takunii/mami-kbd/doc/electronic-products.md

## 商品購入リスト

- 3.7V 2000mAh Lipo ポリマーリチウム充電式バッテリー 103450 × 2Pcs
- Sk6812 MINI-E rgb (ws2812bと同様) sk6812 3228 smdピクセルLED ×　50Pcs
- MSS-22D18 X-2mm Black ×　20Pcs
- 6×6×5MM モメンタリ触覚タクトプッシュボタン × 10Pcs
- GRAEATZT NFR52840 ボード × 3Pcs
- 5ペアマイクロ JST PH2.0 2PIN オスメスプラグコネクターワイヤーケーブル 80mm ×　5 pair
- Kailhホットスワップ可能PCBソケット　× 70Pcs
- 9Cherry MX スイッチPCB実装スタップインスタビライザー 2u × 2Pcs
- 123 パッチスイッチダイオード × 100Pcs
