takunii/mami-kbd/version.md

## v3.5-screw
ケース高さを調節、ハウジングが横から見えないように修正

#v3.3
