takunii/mami-kbd/doc/pin-assignment-final.md

# mami42 最終ピンアサイン（裏面実装最適化）

> ⚠️ **2026-08-08 訂正**: 以下の本文は設計当初の計画であり、実際にPCB上で
> 配線されたピンとは異なることが判明しました。実機の配線(`cad/mami.kicad_pcb`の
> ネット情報で確認済み)は `boards/shields/mami42/mami42.overlay` の
> `row-gpios`/`col-gpios` が正です。実際の対応は以下の通りです:
>
> | 信号 | GPIO |
> |---|---|
> | row0 | P0.31 |
> | row1 | P1.11 |
> | row2 | P0.10 |
> | row3 | P0.09 |
> | row4 | P0.17 |
> | row5 | P0.11 |
> | row6 | P1.04 |
> | row7 | P1.06 |
> | col0 | P0.29 |
> | col1 | P0.02 |
> | col2 | P1.15 |
> | col3 | P0.20 |
> | col4 | P0.22 |
> | col5 | P0.24 |
>
> 以下の本文・表・コード例は当時の計画のまま残していますが、内容が古い点に注意してください。

## 🎯 最適化の考え方

### PCB裏面実装での配置
```
        PCB表面から見た配置
        
マトリクス左側          nice!nano(裏面)          マトリクス右側
  (左に配置)            (中央に配置)              (右に配置)
                    
                    回路図右側ピン
                    → 実装後は左側
                    → マトリクス左側に近い！
                    
                    回路図左側ピン  
                    → 実装後は右側
                    → マトリクス右側に近い！
```

### ✅ 最適化の原則
1. **ROW左側（4本）**: 回路図の**右側ピン**を使用 → 実装後は左側
2. **ROW右側（4本）**: 回路図の**左側ピン**を使用 → 実装後は右側
3. **COL（6本）**: 残りのピンを上側から順に使用
4. **横断配線を最小化**: ROWが左右に分かれているため横断不要

## 🔧 確定ピンアサイン

### 列（COL）ピン - 6本
```
col0: Pin 1  (P0.06/TX0)  - 回路図左側最上部 → 実装後は右側
col1: Pin 2  (P0.08/RX1)  - 回路図左側上部   → 実装後は右側
col2: Pin 5  (P0.17)      - 回路図左側上部   → 実装後は右側
col3: Pin 6  (P0.20)      - 回路図左側中央   → 実装後は右側
col4: Pin 7  (P0.22)      - 回路図左側中央   → 実装後は右側
col5: Pin 8  (P0.24)      - 回路図左側中央   → 実装後は右側
```
**配置**: COLが中央（実装後右側）に集約され、左右のマトリクスに配線しやすい

### 行（ROW）ピン - 左側4本
```
row0: Pin 13 (P0.09/NFC1) - 回路図右側最上部 → 実装後は左側 ⭐
row1: Pin 14 (P0.10/NFC2) - 回路図右側上部   → 実装後は左側 ⭐
row2: Pin 15 (P1.11)      - 回路図右側上部   → 実装後は左側 ⭐
row3: Pin 16 (P1.13)      - 回路図右側上部   → 実装後は左側 ⭐
```
**配置**: 実装後は左側に来るため、マトリクス左側への配線が短い！

### 行（ROW）ピン - 右側4本
```
row4: Pin 9  (P1.00)      - 回路図左側下部   → 実装後は右側 ⭐
row5: Pin 10 (P0.11)      - 回路図左側下部   → 実装後は右側 ⭐
row6: Pin 11 (P1.04)      - 回路図左側下部   → 実装後は右側 ⭐
row7: Pin 12 (P1.06)      - 回路図左側最下部 → 実装後は右側 ⭐
```
**配置**: 実装後は右側に来るため、マトリクス右側への配線が短い！

### 電源・その他
```
VCC:   Pin 21 (回路図右側下部)
GND:   Pin 3, 4, 23, 30
RST:   Pin 22 (回路図右側下部)
BATIN: Pin 24, 34 (回路図右側下部)
```

## 📐 配線イメージ（実装後・表面から見た場合）

```
マトリクス左側                nice!nano(裏面)               マトリクス右側
  (物理4行)                   (表面から見て)                  (物理4行)
                        
  row0 ─────→ Pin 13 (左側上部) ←─ 短い！
  row1 ─────→ Pin 14                         
  row2 ─────→ Pin 15                          Pin 9 (右側下部) ←──── row4
  row3 ─────→ Pin 16                          Pin 10             ←──── row5
                                              Pin 11             ←──── row6
                                              Pin 12 (右側下部)  ←──── row7
                                                     ↑
                                                   短い！
                                                   
  ← COL信号は中央(右側)から左右に分配 →
     Pin 1-8 (右側上～中央)
```

## ✅ この配線の利点

### 1. 横断配線がゼロ
- **ROW左（13-16）** → 実装後左側 → マトリクス左側に直接配線
- **ROW右（9-12）** → 実装後右側 → マトリクス右側に直接配線
- 横断する必要なし！

### 2. 配線が短い
- ROW信号が各マトリクス側に近い位置から出る
- 配線長が最短

### 3. 信号の分離
- ROW左は上部（Pin 13-16）
- ROW右は下部（Pin 9-12）
- 上下で分離されているため交差なし

### 4. COL信号の配線
- COL（Pin 1-8）は実装後右側中央に位置
- 左右のマトリクスに均等にアクセス可能

## 📊 ピン配置一覧表

| 機能 | Pin | GPIO | 回路図位置 | 実装後位置 | マトリクス |
|---|-----|---|---|---|---|
| col0 | 1 | P0.06 | 左上 | 右上 | 全体 |
| col1 | 2 | P0.08 | 左上 | 右上 | 全体 |
| col2 | 5 | P0.17 | 左上 | 右上 | 全体 |
| col3 | 6 | P0.20 | 左中 | 右中 | 全体 |
| col4 | 7 | P0.22 | 左中 | 右中 | 全体 |
| col5 | 8 | P0.24 | 左中 | 右中 | 全体 |
| row0 | 13 | P0.09 | 右上 | **左上** | **左側** ⭐ |
| row1 | 14 | P0.10 | 右上 | **左上** | **左側** ⭐ |
| row2 | 15 | P1.11 | 右上 | **左上** | **左側** ⭐ |
| row3 | 16 | P1.13 | 右上 | **左上** | **左側** ⭐ |
| row4 | 9 | P1.00 | 左下 | **右下** | **右側** ⭐ |
| row5 | 10 | P0.11 | 左下 | **右下** | **右側** ⭐ |
| row6 | 11 | P1.04 | 左下 | **右下** | **右側** ⭐ |
| row7 | 12 | P1.06 | 左下 | **右下** | **右側** ⭐ |

⭐ = 最適配置（横断配線なし）

## 🔌 回路図での接続方法

### nice!nanoシンボルの接続
```
nice!nano (回路図シンボル)

左側ピン:
1  → col0 (左右マトリクス全体へ)
2  → col1
5  → col2
6  → col3
7  → col4
8  → col5
9  → row4 (右側マトリクスへ) ⭐
10 → row5 (右側マトリクスへ) ⭐
11 → row6 (右側マトリクスへ) ⭐
12 → row7 (右側マトリクスへ) ⭐

右側ピン:
13 → row0 (左側マトリクスへ) ⭐
14 → row1 (左側マトリクスへ) ⭐
15 → row2 (左側マトリクスへ) ⭐
16 → row3 (左側マトリクスへ) ⭐
21 → VCC
22 → RST
23 → GND
24 → BATIN
```

## 💻 ZMK ファームウェア設定

```dts
/ {
    chosen {
        zmk,kscan = &kscan0;
    };

    kscan0: kscan {
        compatible = "zmk,kscan-gpio-matrix";
        label = "KSCAN";
        diode-direction = "col2row";
        
        row-gpios
            = <&gpio0 9 (GPIO_ACTIVE_HIGH | GPIO_PULL_DOWN)>   // P0.09 - row0 (左側)
            , <&gpio0 10 (GPIO_ACTIVE_HIGH | GPIO_PULL_DOWN)>  // P0.10 - row1 (左側)
            , <&gpio1 11 (GPIO_ACTIVE_HIGH | GPIO_PULL_DOWN)>  // P1.11 - row2 (左側)
            , <&gpio1 13 (GPIO_ACTIVE_HIGH | GPIO_PULL_DOWN)>  // P1.13 - row3 (左側)
            , <&gpio1 0 (GPIO_ACTIVE_HIGH | GPIO_PULL_DOWN)>   // P1.00 - row4 (右側)
            , <&gpio0 11 (GPIO_ACTIVE_HIGH | GPIO_PULL_DOWN)>  // P0.11 - row5 (右側)
            , <&gpio1 4 (GPIO_ACTIVE_HIGH | GPIO_PULL_DOWN)>   // P1.04 - row6 (右側)
            , <&gpio1 6 (GPIO_ACTIVE_HIGH | GPIO_PULL_DOWN)>   // P1.06 - row7 (右側)
            ;

        col-gpios
            = <&gpio0 6 GPIO_ACTIVE_HIGH>   // P0.06 - col0
            , <&gpio0 8 GPIO_ACTIVE_HIGH>   // P0.08 - col1
            , <&gpio0 17 GPIO_ACTIVE_HIGH>  // P0.17 - col2
            , <&gpio0 20 GPIO_ACTIVE_HIGH>  // P0.20 - col3
            , <&gpio0 22 GPIO_ACTIVE_HIGH>  // P0.22 - col4
            , <&gpio0 24 GPIO_ACTIVE_HIGH>  // P0.24 - col5
            ;
    };
};
```

## 📝 マトリクス配線対応表

### 左側マトリクス（物理1～4行目）
| 物理行 | 回路図 | ピン | GPIO | 実装後位置 |
|---|---|-----|---|---|
| 1行目 | row0 | 13 | P0.09 | 左側上部 ⭐ |
| 2行目 | row1 | 14 | P0.10 | 左側上部 ⭐ |
| 3行目 | row2 | 15 | P1.11 | 左側上部 ⭐ |
| 4行目 | row3 | 16 | P1.13 | 左側上部 ⭐ |

### 右側マトリクス（物理1～4行目）
| 物理行 | 回路図 | ピン | GPIO | 実装後位置 |
|---|---|-----|---|---|
| 1行目 | row4 | 9 | P1.00 | 右側下部 ⭐ |
| 2行目 | row5 | 10 | P0.11 | 右側下部 ⭐ |
| 3行目 | row6 | 11 | P1.04 | 右側下部 ⭐ |
| 4行目 | row7 | 12 | P1.06 | 右側下部 ⭐ |

## ✅ まとめ

### この最終ピンアサインを使用する理由：
1. **横断配線ゼロ**: ROWが左右に分かれているため
2. **配線が最短**: 各ROWが対応するマトリクス側に直接接続
3. **信号の分離**: 上下で分離され交差なし
4. **PCB設計が簡単**: ルーティングが直感的

### このピンアサインで回路図を作成してください！
