takunii/mami-kbd/doc/case.md

## アルミニウムケースの寸法決め

### パーツ寸法

### レイヤー毎の寸法
PCB幅　253.0/87.5
ケース内側  　
ケース外側

|外側ケース|ガスケット|基盤|
|:--:|:--:|:--:|
||b|c|
||||
