takunii/mami-kbd/doc/why-capacitors-required.md

# なぜコンデンサ・抵抗が必要か - LED有無に関わらず必須

## ❌ よくある誤解

> 「LEDなしにするから、コンデンサは不要だよね？」

**これは間違いです！**

## ✅ 正しい理解

### LED有無とコンデンサの関係

```
LED有り の場合:
├── 基本コンデンサ（必須）
│   ├── デカップリング 0.1μF × 4-5個  ← マイコン用（必須）
│   └── バイパス 10μF × 1-2個         ← マイコン用（必須）
└── LED用コンデンサ（追加）
    └── バイパス 10μF × 2個           ← LED電源安定化用

LED無し の場合:
└── 基本コンデンサ（必須）
    ├── デカップリング 0.1μF × 4-5個  ← マイコン用（必須）
    └── バイパス 10μF × 1-2個         ← マイコン用（必須）
```

**LEDをなしにしても、基本コンデンサは必須です！**

---

## 🔌 なぜコンデンサが必須なのか

### 1. デカップリングキャパシタ（0.1μF × 4-5個）

#### 役割: マイコンの電源ノイズ除去

```
VCC (3.3V) ─┬───────── nice!nano/GRAEATZT NFR52840
            │
            ├─ [C1: 0.1μF] ── GND
            ├─ [C2: 0.1μF] ── GND
            ├─ [C3: 0.1μF] ── GND
            └─ [C4: 0.1μF] ── GND

配置: マイコンの近く（5mm以内）
```

#### なぜ必要か

**マイコンの内部動作:**
- CPUクロック: 64MHz（nRF52840）
- GPIO切り替え: 数MHz～数十MHz
- 無線通信: 2.4GHz
- これらが**瞬間的に電流を消費**

**コンデンサがないと:**
```
❌ 電源電圧が不安定
   → VCC: 3.3V → 3.1V → 3.4V → 2.9V...（変動）
   
❌ 高周波ノイズが発生
   → デジタル信号が乱れる
   
❌ マイコンが誤動作
   → 突然リセット
   → キー入力が認識されない
   → Bluetooth接続が不安定
   → USB通信エラー
```

**コンデンサがあると:**
```
✅ 瞬間的な電流変動を吸収
✅ 電源電圧を3.3Vに安定維持
✅ 高周波ノイズを除去
✅ マイコンが安定動作
```

---

### 2. バイパスキャパシタ（10μF × 1-2個）

#### 役割: 電源電圧の急激な変動を抑制

```
VCC (3.3V) ─┬───────── nice!nano/GRAEATZT NFR52840
            │
            └─ [C_BYPASS: 10μF] ── GND

配置: マイコンの直近
```

#### なぜ必要か

**マイコンの動作モード変化:**
```
スリープモード: 数μA
  ↓ 突然の変化
通信モード: 数十mA～100mA以上
```

この**瞬間的な電流変化**が問題になります。

**バイパスキャパシタがないと:**
```
❌ スリープ→通信時に電圧降下
   VCC: 3.3V → 2.8V（瞬間的）
   
❌ マイコンが電圧不足でリセット
   → 突然再起動
   → Bluetooth切断
   → キー入力が消える
```

**バイパスキャパシタがあると:**
```
✅ コンデンサに貯めた電荷で瞬間的な電流をカバー
✅ 電源電圧の急激な降下を防ぐ
✅ マイコンが安定動作
```

---

### 3. プルアップ抵抗（10kΩ × 1個）

#### 役割: リセットピンを安定させる

```
VCC (3.3V)
  │
  └─ [R1: 10kΩ] ──┬── nice!nano Pin 22 (RST)
                   │
               [SW_RST]
                   │
                  GND
```

#### なぜ必要か

**RSTピンの特性:**
- Low (0V): リセット実行
- High (3.3V): 通常動作
- **未接続（フローティング）: 不定（危険！）**

**プルアップ抵抗がないと:**
```
❌ RSTピンがフローティング状態
   → ノイズで勝手にLowになる
   → 突然リセット
   → 常にリセット状態で起動しない
```

**プルアップ抵抗があると:**
```
✅ RSTピンを常にHighに保つ
✅ ボタンを押したときだけLowになる
✅ 正常にリセット機能が動作
```

---

## 📊 LED有無による部品の違い

### LED無しの場合（初号機）

#### 必須部品
| 部品 | 数量 | 用途 | LED有無 |
|---|---|---|---|
| 0.1μF コンデンサ (0603) | 4-5個 | デカップリング | **常に必須** ⭐ |
| 10μF コンデンサ (0805) | 1-2個 | バイパス | **常に必須** ⭐ |
| 10kΩ 抵抗 (0603) | 1個 | リセット回路 | **常に必須** ⭐ |

#### 不要な部品
| 部品 | 数量 | 用途 | LED有無 |
|---|---|---|---|
| 470Ω 抵抗 (0603) | 1個 | LED信号保護 | LED無しなら不要 |
| 10μF コンデンサ (0805) | 2個追加 | LED電源安定化 | LED無しなら不要 |
| SK6812 MINI-E LED | 42-50個 | バックライト | LED無しなら不要 |

---

## 🎯 LED無し初号機の最終購入リスト

### ✅ 既に購入予定（確定）
- [x] GRAEATZT NFR52840 × 3個
- [x] 3.7V 2000mAh バッテリー × 2個
- [x] JST PH2.0 コネクター × 5ペア
- [x] MSS-22D18 パワースイッチ × 20個
- [x] Kailhホットスワップソケット × 70個
- [x] ダイオード 1N4148W × 100個
- [x] タクトスイッチ 6×6×5mm × 10個
- [x] 2u スタビライザー × 2個

### ❌ 絶対に追加購入が必要
- [ ] **0.1μF セラミックコンデンサ (0603) × 5個以上**
- [ ] **10μF セラミックコンデンサ (0805) × 2個以上**
- [ ] **10kΩ 抵抗 (0603) × 1個以上**

### 不要（LEDなしのため）
- ~~SK6812 MINI-E LED × 50個~~ → 保留または返品
- ~~470Ω 抵抗~~ → 不要
- ~~LED用追加10μFコンデンサ~~ → 不要

---

## 💰 推奨購入: アソートセット

### なぜアソートセットが良いか

**個別購入の問題:**
```
0.1μF × 5個: 送料込み $5
10μF × 2個: 送料込み $5
10kΩ × 1個: 送料込み $5
─────────────────────
合計: $15
```

**アソートセット:**
```
SMD 0603/0805 コンデンサ・抵抗セット
- 0.1μF × 20-50個
- 10μF × 20-50個
- 10kΩ × 20-50個
- その他各値も含む
価格: $8-12（送料込み）
```

**メリット:**
- ✅ 安い（$15 → $10程度）
- ✅ 予備がたくさん（失敗しても安心）
- ✅ 今後のプロジェクトに使える
- ✅ 2号機（LED有り）を作るときにも使える

---

## 🔍 実際の失敗例

### ケース1: コンデンサなしで作った人
```
状況: デカップリングキャパシタを省略
結果: 
- キーを押すとマイコンがリセット
- Bluetooth接続が数秒で切れる
- USB接続が不安定
解決: コンデンサを追加して正常動作
```

### ケース2: プルアップ抵抗なしで作った人
```
状況: リセット回路の抵抗を省略
結果:
- 電源を入れても起動しない
- 常にリセット状態
- ファームウェアを書き込めない
解決: 10kΩ抵抗を追加して正常動作
```

---

## ✅ まとめ

### LED有無に関係なく必須
1. **0.1μF コンデンサ × 4-5個** - マイコンのノイズ除去
2. **10μF コンデンサ × 1-2個** - 電源安定化
3. **10kΩ 抵抗 × 1個** - リセット回路

### これらがないと
- ❌ マイコンが誤動作・突然リセット
- ❌ Bluetooth/USB通信が不安定
- ❌ キー入力が認識されない
- ❌ リセットボタンが機能しない
- ❌ 最悪の場合、全く動作しない

### LEDをなしにして減る部品
- LED本体 × 42-50個
- LED用470Ω抵抗 × 1個
- LED用追加10μFコンデンサ × 2個

**基本のコンデンサ・抵抗は絶対に必要です！**

---

## 🛒 今すぐ購入すべきもの

```
AliExpressで検索:
"SMD 0603 0805 capacitor resistor kit"

推奨商品:
- SMD 0603/0805 コンデンサ・抵抗アソートセット
- 価格: $8-15
- 各値10-50個入り
```

**これを1セット買えば、すべて解決します！**

LED有り2号機を作るときも使えるので、今買っておくのがベストです。
