takunii/mami-kbd/image.png

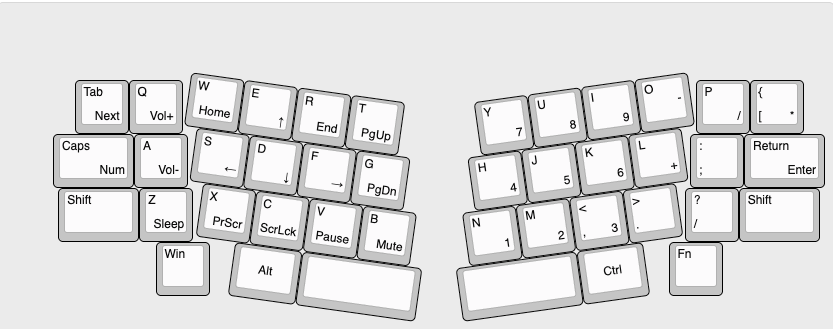
image.png
