takunii/mami-kbd/doc/shopping-list-review.md

# mami42 電子部品購入リスト - レビューと追加必要部品

## 📋 現在の購入予定リスト（確認）

| 部品名 | 数量 | 用途 | ステータス |
|---|---|---|---|
| 3.7V 2000mAh Lipo バッテリー 103450 | 2個 | 無線電源 | ✅ OK（容量大きめで良い） |
| SK6812 MINI-E RGB LED (3228 SMD) | 50個 | キーバックライト | ⚠️ 確認必要 |
| MSS-22D18 X-2mm Black | 20個 | パワースイッチ？ | ⚠️ 用途確認 |
| 6×6×5MM タクトスイッチ | 10個 | リセットボタン | ✅ OK |
| GRAEATZT NFR52840 ボード | 3個 | マイコン | ⚠️ nice!nano推奨 |
| JST PH2.0 2PIN コネクター 80mm | 5ペア | バッテリー接続 | ✅ OK |
| Kailhホットスワップソケット | 70個 | キースイッチ | ✅ OK（余裕あり） |
| 2u Cherry MXスタビライザー | 2個 | 2uキー用 | ⚠️ 数量確認 |
| パッチダイオード（1N4148W？） | 100個 | キーマトリクス | ✅ OK |

---

## ⚠️ 重要な確認事項

### 1. マイコンボード - ✅ 確認済み
**現在:** GRAEATZT NFR52840 ボード × 3個

**ステータス: ✅ OK**
- nice!nano v2互換確認済み
- Pro Micro互換ピン配置
- 1個で十分だが、予備に3個購入は賢明
- 購入URL確認済み（AliExpress）

**このまま使用できます！**

---

### 2. SK6812 MINI-E LED - 重要な設計変更
**LED追加による影響:**

#### ピンアサインの変更が必要
- **データピン追加**: SK6812はシリアル制御のため、1本のデータピンが必要
- **現在の設計**: GPIO 14本使用（COL 6本 + ROW 8本）
- **LED用ピン**: Pin 17 (P1.15) などを使用可能

#### LED接続方法
```
nice!nano Pin 17 (P1.15)
    │
    └─→ [First LED] → [Second LED] → ... → [42nd LED]
         ↓           ↓                    ↓
        SW1         SW2                  SW42
        
各LEDの電源:
VCC ─┬─ LED1 VDD
     ├─ LED2 VDD
     └─ LED42 VDD
     
GND ─┬─ LED1 GND
     ├─ LED2 GND
     └─ LED42 GND
```

#### 追加で必要な設計変更
1. **回路図の修正**: LED回路の追加
2. **PCB設計の修正**: 各キースイッチ下にLED配置スペース
3. **電力計算**: 42個のLED消費電力を考慮
   - SK6812 MINI-E: 最大15mA/色 × 3色 = 45mA/個
   - 全点灯: 42個 × 45mA = 1.89A（最大）
   - 実用: 約500mA（明るさ調整で使用）

#### バッテリー容量の見直し
- **現在**: 2000mAh Li-Po
- **LED付きの場合**:
  - LED消費: 平均300-500mA
  - nice!nano: 約5-10mA
  - 合計: 約310-510mA
  - **稼働時間**: 2000mAh ÷ 500mA = 約4時間
  - ✅ 容量は十分

---

### 3. スタビライザー - ✅ 確認済み
**現在:** 2u スタビライザー × 2個

**ステータス: ✅ OK**
- スペースキー: 2u × 2個
- 合計2個の2uスタビライザーで十分
- 追加購入不要

**このまま使用できます！**

---

### 4. MSS-22D18 スイッチ - ✅ 確認済み
**購入予定:** MSS-22D18 X-2mm Black × 20個

**ステータス: ✅ OK**
- 用途: パワースイッチ（バッテリーON/OFF）
- 立った状態で実装可能（MSK-12C02は寝た状態なので不採用）
- 実際には1個のみ使用、残り19個は予備
- AliExpressの最小購入単位が20個のため

**このまま使用できます！**

---

## ❌ 足りない部品リスト（重要！）

### ⚠️ 絶対に必要な部品（電源回路）

**これらがないとキーボードが動作しません！**

| 部品名 | 型番推奨 | 数量 | 用途 | なぜ必要か |
|---|---|---|---|---|
| セラミックコンデンサ 0.1μF | 0603 | 5個 | デカップリング | マイコンの電源ノイズ除去。**ないとマイコンが誤動作・リセットする** |
| セラミックコンデンサ 10μF | 0805 | 2個 | バイパス | 電源電圧の急激な変動を抑制。**ないとマイコンが安定動作しない** |
| 抵抗 10kΩ | 0603 | 1-2個 | リセット回路 | リセットピンをVCCにプルアップ。**ないとリセットボタンが機能しない** |

### 推奨部品（LED用）
| 部品名 | 型番推奨 | 数量 | 用途 | 理由 |
|---|---|---|---|---|
| 抵抗 470Ω | 0603 | 1個 | LED信号保護 | データピン保護（短絡・サージ対策） |
| コンデンサ 10μF | 0805 | 2個追加 | LED電源安定化 | 42個LED点灯時の電流変動を抑制 |
| 保護ダイオード | 1N4148W (SOD-123) | 1個 | バッテリー保護 | 逆接続時の保護（推奨） |

### 💡 なぜコンデンサ・抵抗が必要か

#### デカップリングキャパシタ（0.1μF × 5個）
```
VCC ─┬─ nice!nano
     │
     ├─ [C1: 0.1μF] ─┬─ GND （マイコン左上近く）
     ├─ [C2: 0.1μF] ─┤
     ├─ [C3: 0.1μF] ─┤
     ├─ [C4: 0.1μF] ─┤
     └─ [C5: 0.1μF] ─┘

役割: 高周波ノイズを除去
ないと: マイコンが誤動作、突然リセット、通信エラー
```

#### バイパスキャパシタ（10μF × 2-4個）
```
VCC ─┬─ nice!nano
     │
     ├─ [C_BYPASS: 10μF] ── GND
     │
     └─ [LED用: 10μF × 2] ── GND

役割: 瞬間的な電流変動を吸収
ないと: 電圧降下でマイコンリセット、LED点滅時の不安定動作
```

#### プルアップ抵抗（10kΩ × 1個）
```
VCC ─── [R1: 10kΩ] ──┬── nice!nano Pin 22 (RST)
                      │
                  [SW_RST]
                      │
                     GND

役割: リセットピンをHighに保つ
ないと: リセットボタン押しても動作しない、または常にリセット状態
```

---

## ✅ 修正後の推奨購入リスト

### マイコン・通信
- [x] **GRAEATZT NFR52840** × 3個（nice!nano v2互換確認済み）

### 電源関連
- [x] 3.7V 2000mAh Li-Po バッテリー × 2個
- [x] JST PH2.0 コネクター × 5ペア
- [x] **パワースイッチ MSS-22D18** × 20個（1個使用、19個予備）

### スイッチ・ダイオード
- [x] Kailhホットスワップソケット × 70個
- [x] ダイオード 1N4148W × 100個
- [x] タクトスイッチ 6×6×5mm × 10個（リセット用）
- [x] 2u スタビライザー × 2個

### LED関連
- [x] SK6812 MINI-E RGB LED × 50個

### ⭐ 追加必要部品
- [ ] **セラミックコンデンサ 0.1μF (0603)** × 10個セット
- [ ] **セラミックコンデンサ 10μF (0805)** × 10個セット
- [ ] **抵抗 10kΩ (0603)** × 10個セット
- [ ] **抵抗 470Ω (0603)** × 10個セット（LED用）

---

## 💰 AliExpress/LCSC購入推奨セット

### ⭐ 推奨: コンデンサ・抵抗アソートメント

**これを1セット購入すれば必要な部品が全部揃います！**

```
🛒 SMD 0603/0805 コンデンサ・抵抗アソートセット
- 各値10-50個入り
- コンデンサ: 0.1μF, 1μF, 10μF など
- 抵抗: 470Ω, 1kΩ, 10kΩ など
価格: 約$5-15
```

**AliExpress検索ワード:**
- "SMD capacitor resistor kit 0603 0805"
- "SMD component assortment kit"
- "0603 0805 capacitor resistor sample book"

**具体的な商品例:**
1. **0603/0805 コンデンサキット** (約$8-12)
   - 0.1μF, 1μF, 10μF, 100μF など各値10-20個
   
2. **0603 抵抗キット** (約$5-8)
   - 470Ω, 1kΩ, 10kΩ, 100kΩ など各値20-50個

3. **オールインワン SMDキット** (約$15-20)
   - コンデンサ・抵抗・ダイオードがセットで入っている
   - 今後のプロジェクトにも使える

**これを購入すれば:**
✅ 必要な部品が全部揃う
✅ 個別購入より安い
✅ 余った部品は今後使える
✅ 失敗・紛失時の予備もある

---

## 🔍 購入前の確認事項

### 1. マイコンの確認
```
GRAEATZT NFR52840ボードのピン配置を確認:
- nice!nano v2互換か？
- Pro Micro互換か？
- ピン配置図を確認してください
```

### 2. LEDの仕様確認
```
SK6812 MINI-E (3228 SMD):
✅ サイズ: 3.2mm × 2.8mm
✅ 電圧: 5V動作が一般的だが、3.3V動作可能か確認
⚠️ 3.3V動作の場合、明るさが低下する可能性
```

### 3. スタビライザーの確認
```
レイアウトを確認して必要な種類を特定:
- 2u: 何個必要か
- 2.25u: 必要か
- 2.75u: 必要か
```

---

## 📦 最終購入チェックリスト

### 確定済み
- [x] バッテリー 2000mAh × 2
- [x] SK6812 MINI-E LED × 50
- [x] タクトスイッチ × 10
- [x] JST PH2.0 コネクター × 5ペア
- [x] Kailhホットスワップソケット × 70
- [x] ダイオード × 100

### ✅ 確認済み
- [x] マイコン: GRAEATZT NFR52840（nice!nano v2互換）
- [x] パワースイッチ: MSS-22D18（立った状態で実装可能）
- [x] スタビライザー: 2u × 2個（スペースキー2u × 2）

### 追加必須
- [ ] **コンデンサ 0.1μF (0603) × 5個以上**
- [ ] **コンデンサ 10μF (0805) × 2個以上**
- [ ] **抵抗 10kΩ (0603) × 2個以上**
- [ ] **抵抗 470Ω (0603) × 1個以上**（LED用）

### 推奨アソート
- [ ] **SMD 0603/0805 コンデンサ・抵抗セット** × 1セット

---

## 🎯 まとめ

### ❌ 絶対に追加購入が必要（動作に必須）
1. **0.1μF コンデンサ (0603) × 5個** - デカップリング用
2. **10μF コンデンサ (0805) × 2-4個** - バイパス・LED電源用
3. **10kΩ 抵抗 (0603) × 1-2個** - リセット回路用
4. **470Ω 抵抗 (0603) × 1個** - LED信号保護用

**💡 推奨:** SMD 0603/0805アソートセット × 1個（$5-15）
→ 上記すべてが含まれており、今後も使える

### ✅ 購入リスト確認済み
- [x] マイコン: GRAEATZT NFR52840 × 3個（nice!nano v2互換）
- [x] パワースイッチ: MSS-22D18 × 20個（立った状態実装）
- [x] スタビライザー: 2u × 2個（十分）
- [x] バッテリー: 2000mAh × 2個
- [x] LED: SK6812 MINI-E × 50個
- [x] その他すべて確認済み

### 📝 LED追加による設計変更が必要
1. 回路図にLED回路追加（データピン: Pin 17推奨）
2. PCBに各キー下のLED配置スペース確保
3. LED用データピン配線追加
4. ZMKファームウェアでRGB設定追加

### 🚨 重要
**コンデンサと抵抗がないと、キーボードは正常動作しません！**
必ずSMD 0603/0805のアソートセットを購入してください。
