takunii/mami-kbd/cad/.step

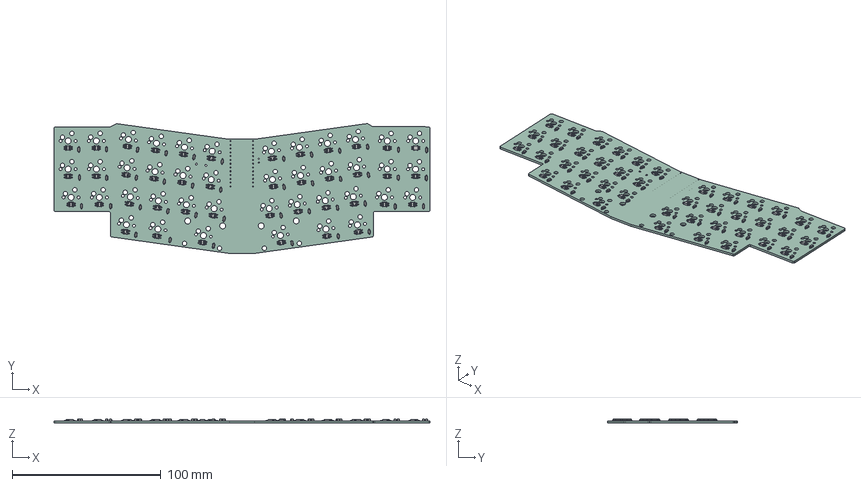
[picture p2: CAD file, 2026-06-06]
cad/.step
253.1 x 87.4 x 2.85 mm
D_SOD-123 x 42
Pin1 x 42
Pin2 x 42
Pin3 x 42
Pin4 x 42
mami_PCB
