takunii/mami-kbd/dxf/pcb_bottom_case.dxf

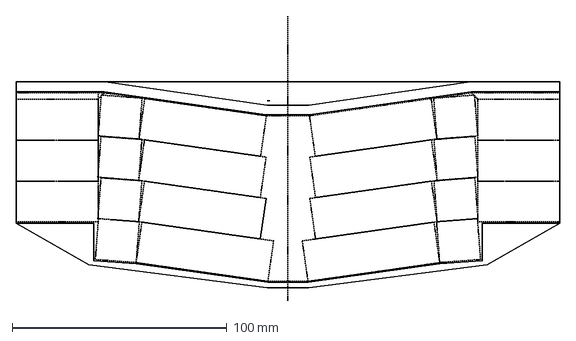
[picture p3: CAD file, 2026-08-04]
dxf/pcb_bottom_case.dxf
252.8 x 132.2 mm
