takunii/mami-kbd/step/carot48_top.step

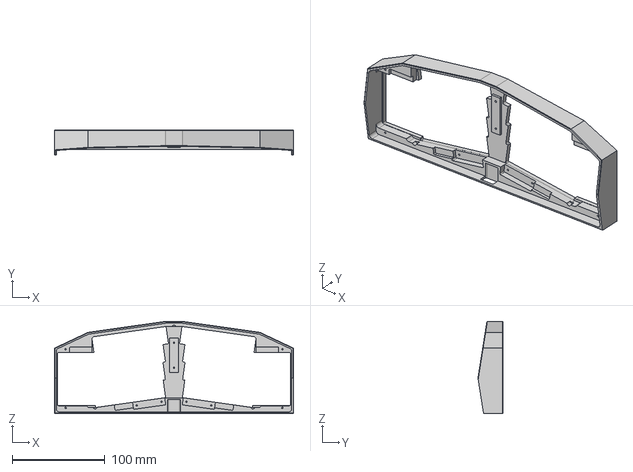
[picture p4: CAD file, 2026-08-04]
step/carot48_top.step
258.0 x 27.1 x 99.6 mm
