takunii/mami-kbd/step/v3.3/carot42_top_case.step

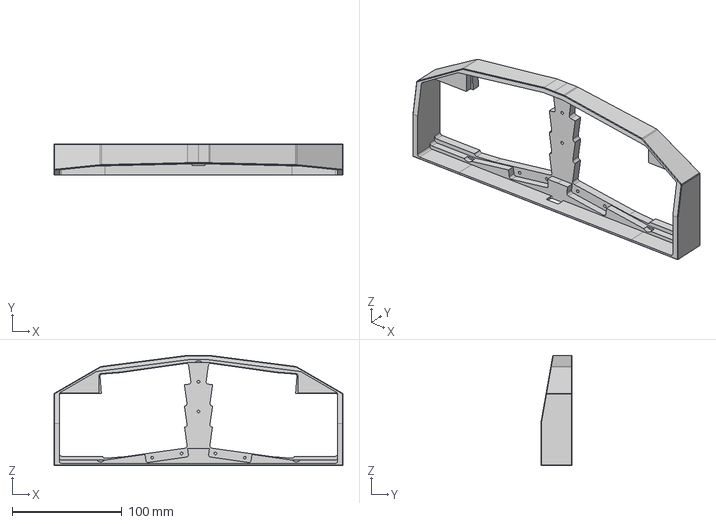
[picture p5: CAD file, 2026-08-04]
step/v3.3/carot42_top_case.step
262.8 x 28.6 x 100.3 mm
