takunii/mami-kbd/symbols/Keebio-Parts.pretty-master/3dmodels/SK6812MINI-E v1.step

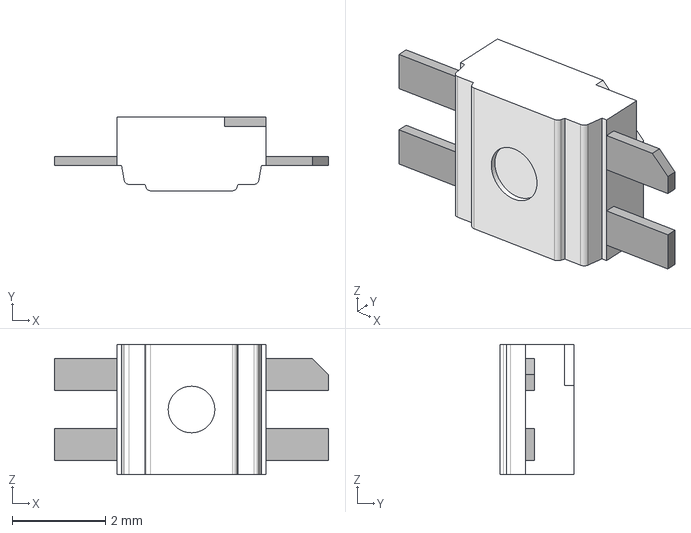
[picture p6: CAD file, 2026-06-15]
symbols/Keebio-Parts.pretty-master/3dmodels/SK6812MINI-E v1.step
5.88 x 1.58 x 2.80 mm
