takunii/mami-kbd/cad/mami-Edge_Cuts.dxf

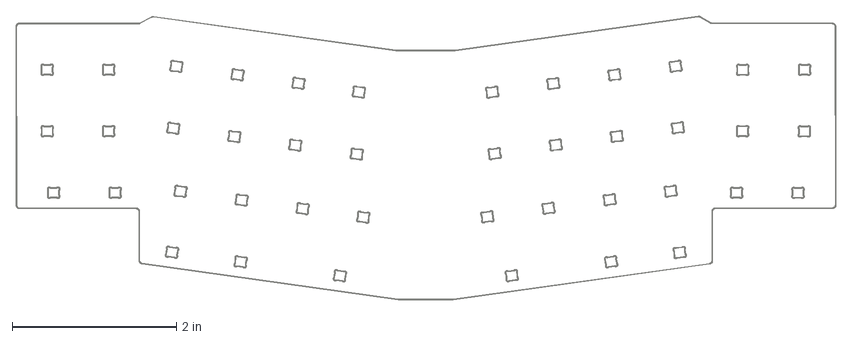
[picture p7: CAD file, 2026-06-06]
cad/mami-Edge_Cuts.dxf
9.97 x 3.44 in
