takunii/mami-kbd/dxf/pcb_edge.dxf

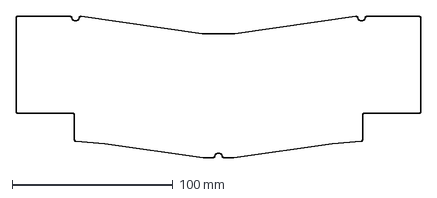
[picture p8: CAD file, 2026-08-04]
dxf/pcb_edge.dxf
251.8 x 87.8 mm
