takunii/mami-kbd/step/carot42_top_20260703.step

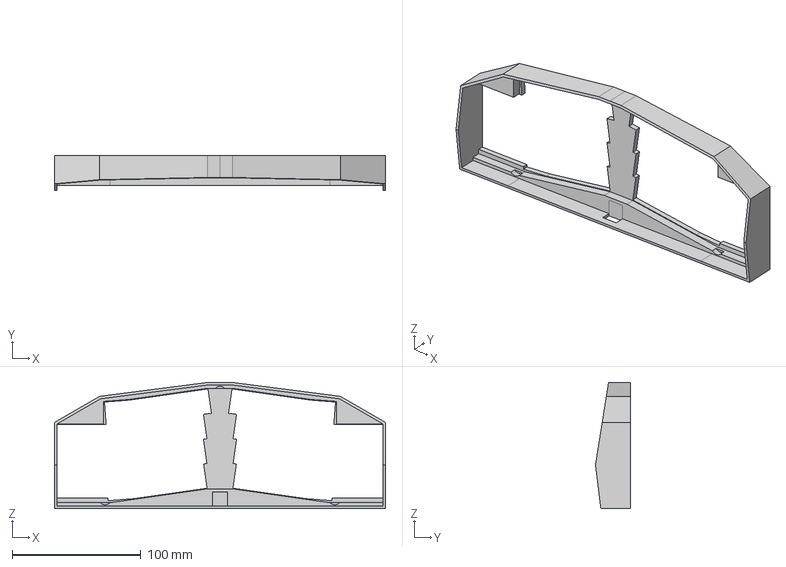
[picture p9: CAD file, 2026-08-04]
step/carot42_top_20260703.step
256.8 x 27.2 x 97.8 mm
