takunii/mami-kbd/step/v3.3/carot42_bottom_case.step

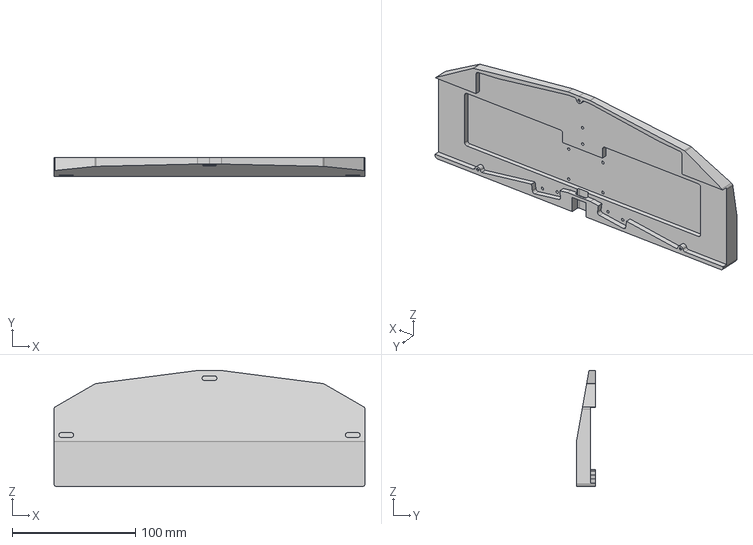
[picture p10: CAD file, 2026-08-04]
step/v3.3/carot42_bottom_case.step
252.8 x 15.6 x 94.3 mm
