takunii/mami-kbd/symbols/Keebio-Parts.pretty-master/3dmodels/CUI_SJ-43614-SMT-TR.step

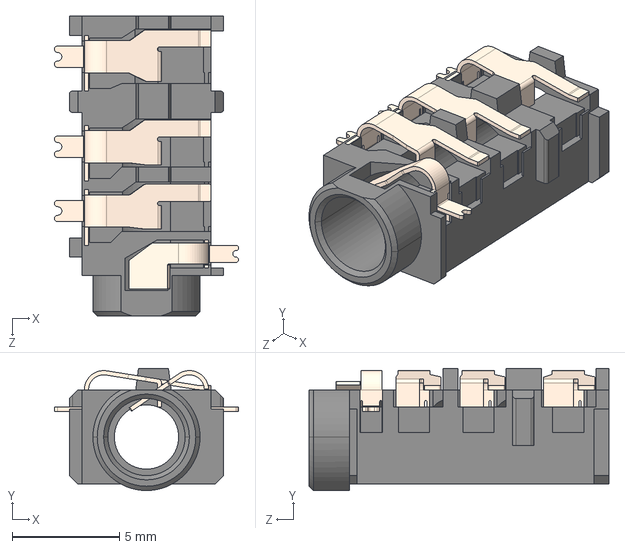
[picture p11: CAD file, 2026-06-15]
symbols/Keebio-Parts.pretty-master/3dmodels/CUI_SJ-43614-SMT-TR.step
8.60 x 5.70 x 14.0 mm
