takunii/mami-kbd/cad/mami-User_Drawings.dxf

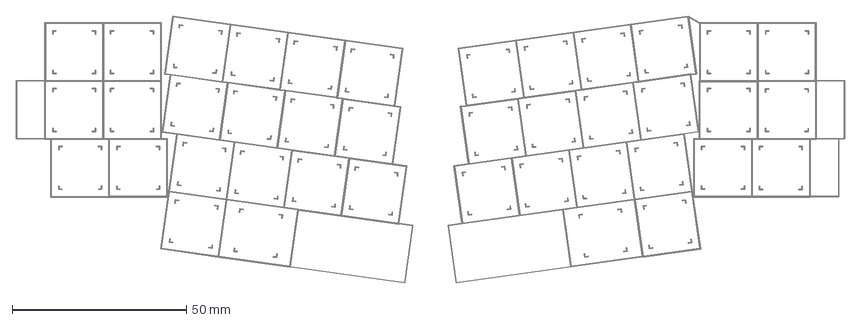
[picture p12: CAD file, 2026-06-06]
cad/mami-User_Drawings.dxf
237.6 x 76.5 mm
