takunii/mami-kbd/dxf/kicad_edge_20260707.dxf

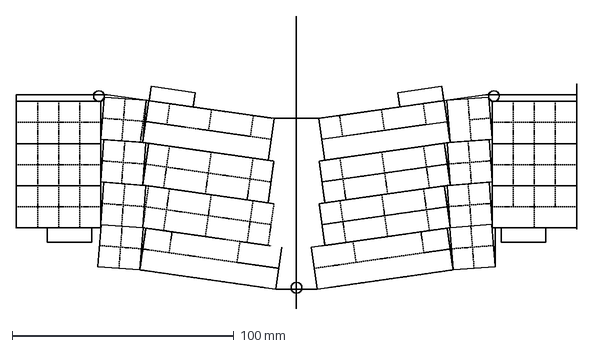
[picture p13: CAD file, 2026-08-04]
dxf/kicad_edge_20260707.dxf
252.8 x 132.2 mm
