takunii/mami-kbd/step/carot42_pcb_edge.dxf

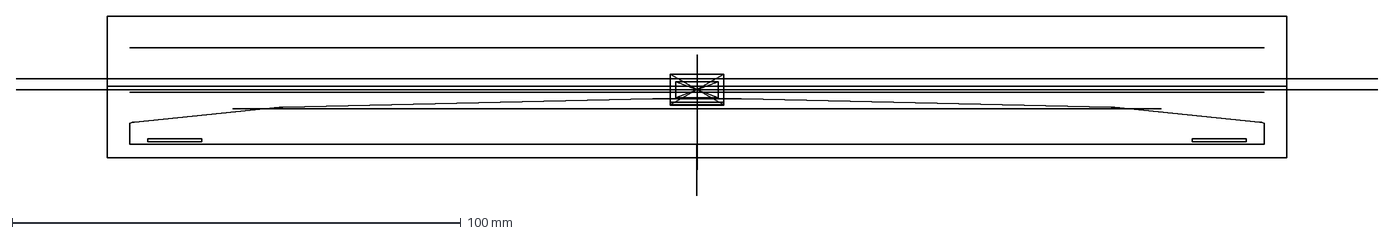
[picture p14: CAD file, 2026-08-04]
step/carot42_pcb_edge.dxf
303.3 x 40.1 mm
