takunii/mami-kbd/symbols/Keebio-Parts.pretty-master/3dmodels/HRO  TYPE-C-31-M-12.step

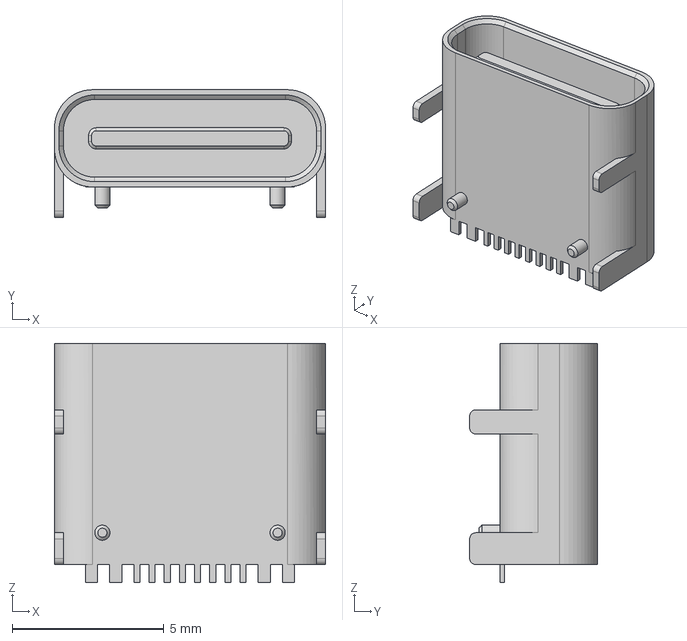
[picture p15: CAD file, 2026-06-15]
symbols/Keebio-Parts.pretty-master/3dmodels/HRO TYPE-C-31-M-12.step
8.94 x 4.21 x 7.90 mm
