takunii/mami-kbd/dxf/kicad_edge.dxf

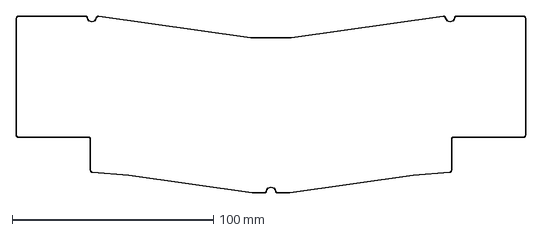
[picture p16: CAD file, 2026-08-04]
dxf/kicad_edge.dxf
252.8 x 87.8 mm
