takunii/mami-kbd/step/carot48_bottom.step

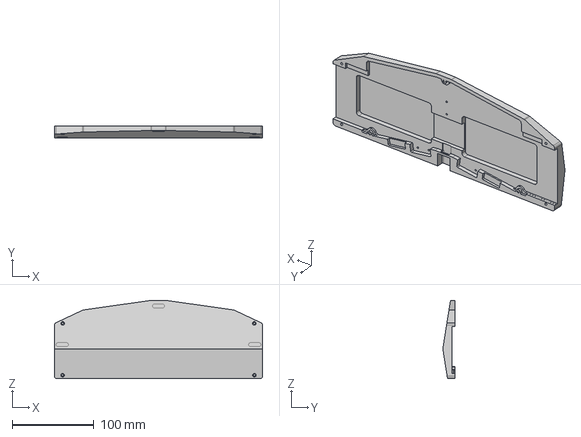
[picture p17: CAD file, 2026-08-04]
step/carot48_bottom.step
254.0 x 15.1 x 95.6 mm
