takunii/mami-kbd/symbols/Keebio-Parts.pretty-master/3dmodels/W25Q16JVUXIQ.step

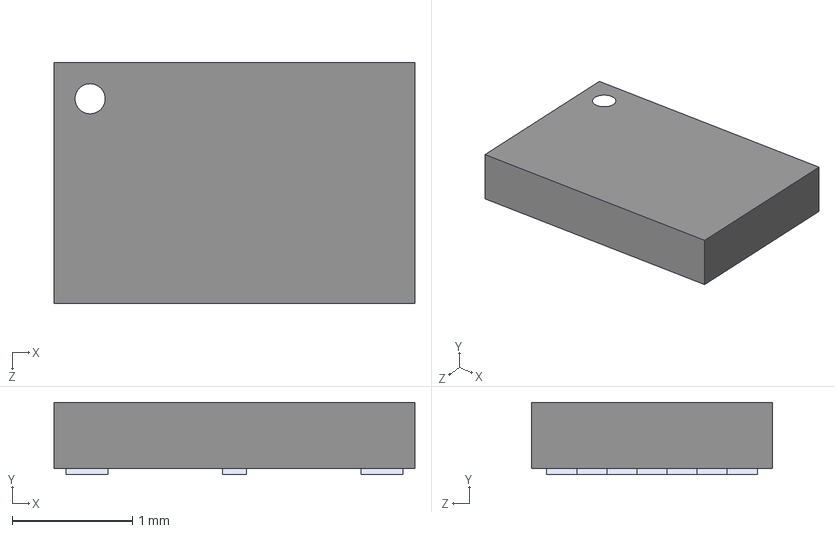
[picture p18: CAD file, 2026-06-15]
symbols/Keebio-Parts.pretty-master/3dmodels/W25Q16JVUXIQ.step
3.00 x 0.6 x 2.00 mm
