takunii/mami-kbd/step/carot42_top_case_v2.2.step

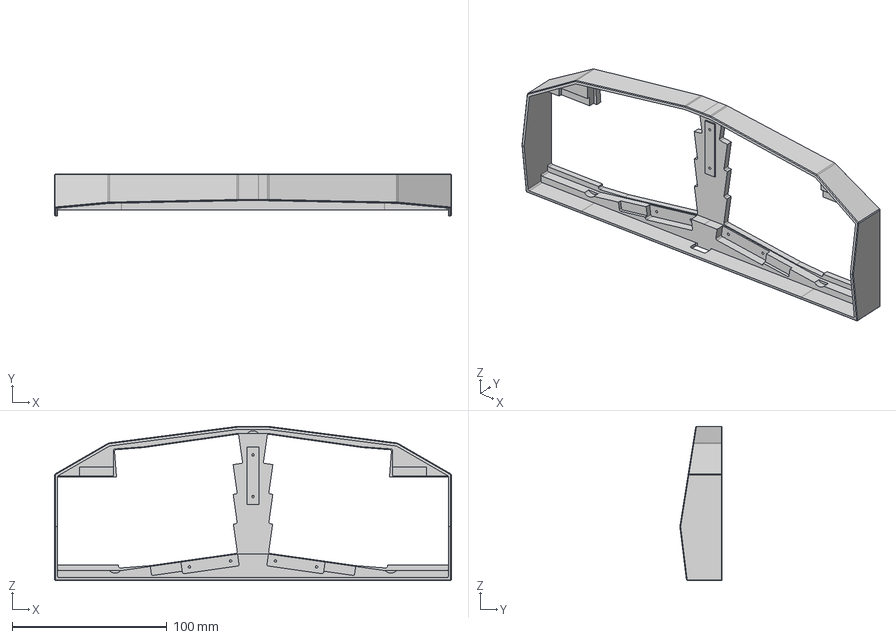
[picture p19: CAD file, 2026-08-04]
step/carot42_top_case_v2.2.step
256.8 x 27.3 x 99.8 mm
