takunii/mami-kbd/symbols/Keebio-Parts.pretty-master/3dmodels/CUI_DEVICES_SJ-43504-SMT-TR.step

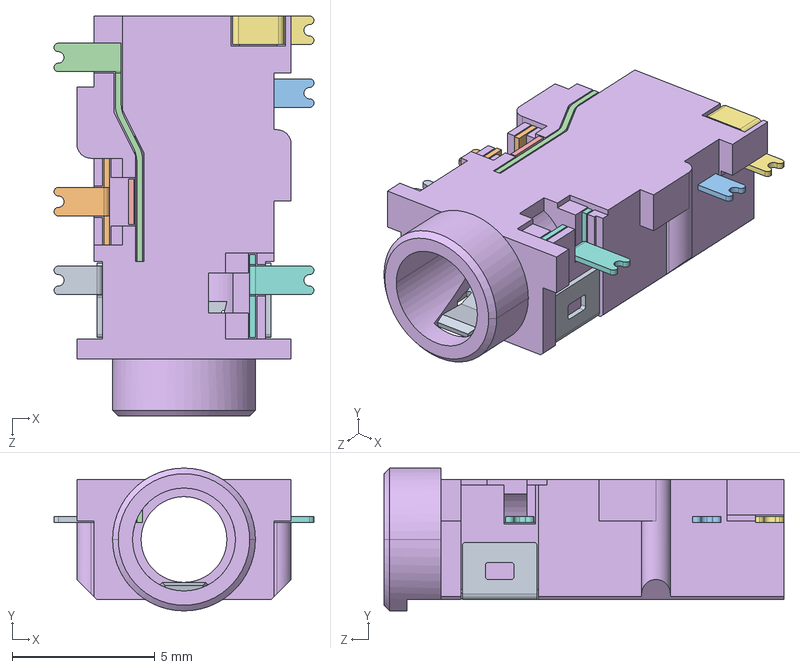
[picture p20: CAD file, 2026-06-15]
symbols/Keebio-Parts.pretty-master/3dmodels/CUI_DEVICES_SJ-43504-SMT-TR.step
9.10 x 5.00 x 14.0 mm
