takunii/mami-kbd/symbols/Keebio-Parts.pretty-master/3dmodels/EC11B-SW-Horiz-15K-blue.step

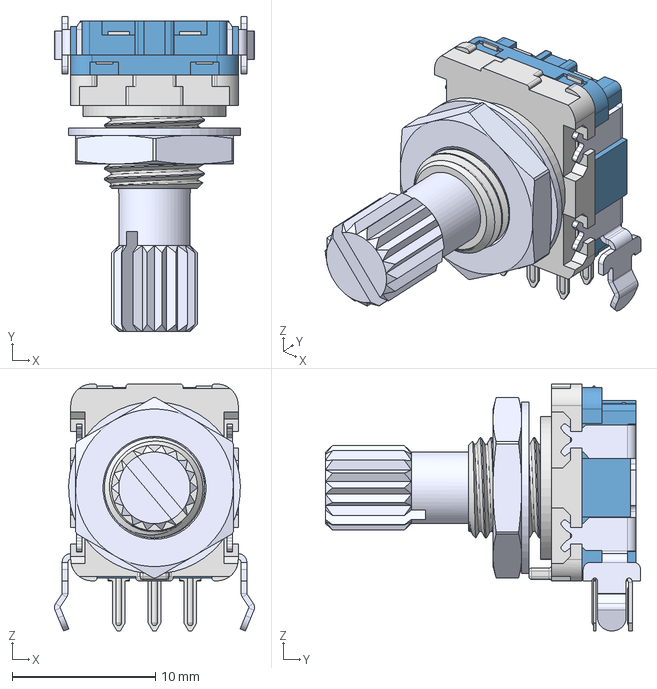
[picture p21: CAD file, 2026-06-15]
symbols/Keebio-Parts.pretty-master/3dmodels/EC11B-SW-Horiz-15K-blue.step
14.0 x 22.0 x 17.3 mm
