takunii/mami-kbd/step/carot42_plate_centerhole.step

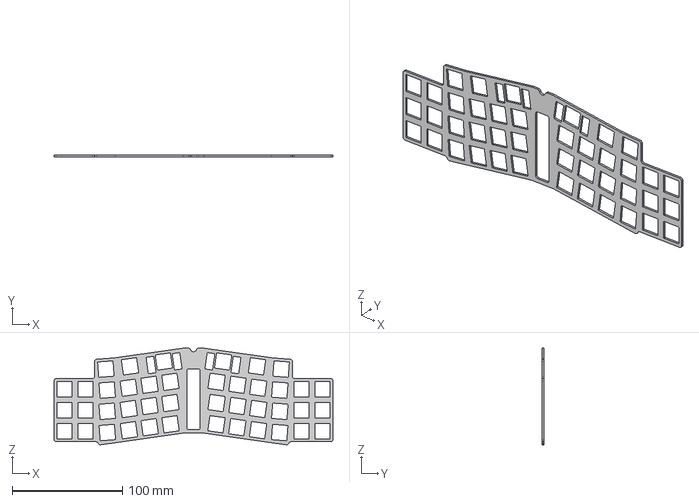
[picture p22: CAD file, 2026-08-04]
step/carot42_plate_centerhole.step
252.8 x 1.60 x 87.6 mm
