takunii/mami-kbd/symbols/Keebio-Parts.pretty-master/3dmodels/PJ-320A.step

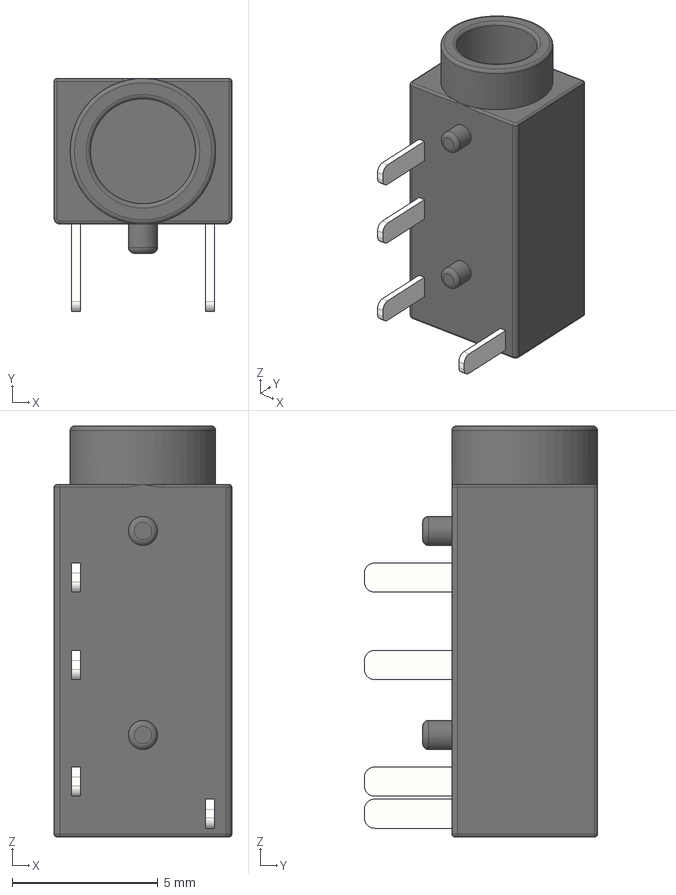
[picture p23: CAD file, 2026-06-15]
symbols/Keebio-Parts.pretty-master/3dmodels/PJ-320A.step
6.10 x 8.00 x 14.1 mm
