takunii/mami-kbd/step/carot42_bottom_20260703.step

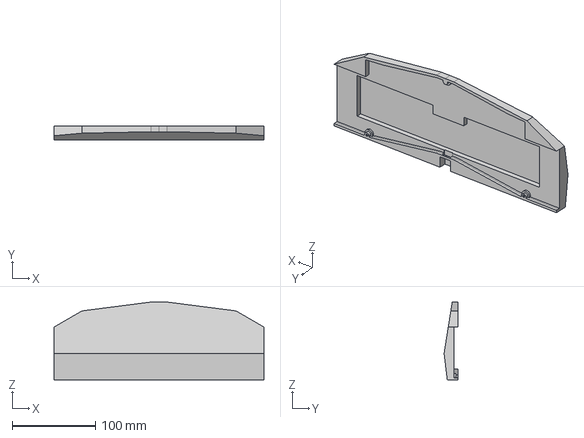
[picture p24: CAD file, 2026-08-04]
step/carot42_bottom_20260703.step
252.8 x 16.7 x 93.8 mm
