takunii/mami-kbd/step/carot42_bottom_case_20260708.step

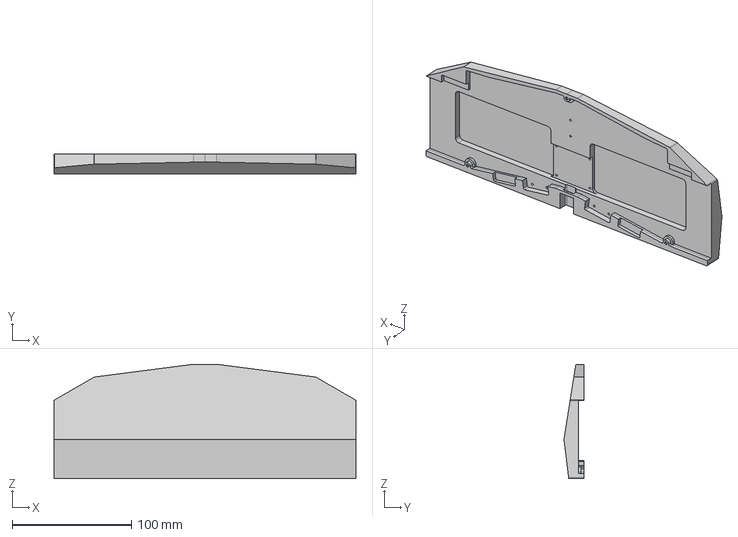
[picture p25: CAD file, 2026-08-04]
step/carot42_bottom_case_20260708.step
252.8 x 16.8 x 95.8 mm
