takunii/mami-kbd/step/carot48.step

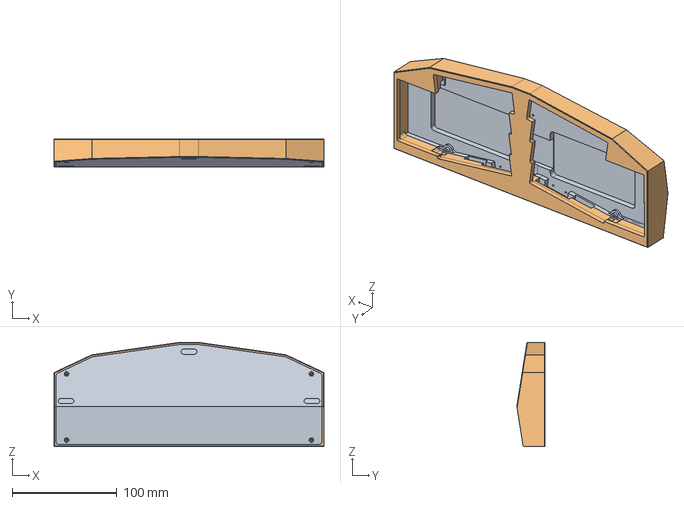
[picture p26: CAD file, 2026-06-10]
step/carot48.step
258.0 x 27.1 x 99.6 mm
