takunii/mami-kbd/(list of files, cad)

Other CAD files:
cad/mami.step
step/carot48_topcase_20260705_zero_offset.step
step/carot42_bottom_case_v2.2.step
step/carot42_top_case_20260708.step
step/carot48_top_20260705_keycap_2R_firret.step
step/carot48_top_20260704.step
step/case_top.step
step/case_bottom.step
cad/carot48.step
cad/mami.dxf
step/kicad_edge_20260707.dxf
step/v3.5_screw/carot42_bottom_case.step
step/v3.5_screw/carot42_v3.5_topcase.step
step/v3/carot42_edge.dxf
step/v3/carot42_plate.step
step/v3/carot42_v3_bottom_case.step
step/v3/carot42_v3_screw_bottom.step
step/v3/carot42_v3_screwtype_bottom.step
step/v3/carot42_v3_top.f3d
step/v3/carot42_v3_top.step
step/v3/carot42_v3_top_screw.step
