takunii/mami-kbd/doc/component-placement-guide.md

# mami42 部品配置ガイド - 表面 vs 裏面

このドキュメントでは、各部品を表面（F.Cu）または裏面（B.Cu）のどちらに配置すべきかをまとめます。

---

## 全体の配置方針

### 基本原則

**表面（F.Cu）**: ユーザーから見える側
- キースイッチ
- LED（アンダーグロー/バックライト）
- ダイオード

**裏面（B.Cu）**: ケース内側
- マイコン（nrf52840/nice!nano）
- バッテリー関連部品
- メンテナンス用部品

---

## 部品別の配置推奨

### 1. キースイッチ（SW1～SW42）

**配置**: **表面（F.Cu）** ⭐必須⭐

#### 理由
- キーキャップがユーザー側に向いている必要がある
- Cherry MXは表面実装が標準
- ホットスワップソケットも表面

#### 注意点
- ホットスワップソケットも表面に配置
- 配線は裏面に引き回してもOK（ビア使用）

---

### 2. ダイオード（D1～D42）

**配置**: **表面（F.Cu）** ⭐推奨⭐

#### 理由
- キースイッチのすぐ近くに配置するため
- 配線が短くなる
- 一般的な実装方法

#### 代替案
- 裏面配置も可能（ビアを多用する必要がある）
- スペースの都合で裏面に配置することもある

---

### 3. LED（D43～D84等）

**配置**: **裏面（B.Cu）** ⭐推奨⭐

#### 理由（リバースマウント）
- SK6812MINI-Eは**リバースマウント**対応
- 裏面に実装し、光を表面に透過させる
- 表面がクリーンになる
- 配線が簡単

#### メリット
- キースイッチと干渉しない
- 見た目がスッキリ
- PCBに穴を開ける必要がない

---

### 4. マイコン（U1: nrf52840/nice!nano）

**配置**: **裏面（B.Cu）** ⭐推奨⭐

#### 理由
- 薄型化（表面はキーだけ）
- Aliceレイアウトの中央スペースに配置
- バッテリーと同じ面で配線が簡単
- USB接続をケース背面/側面に配置可能

#### 配置位置
- 中央スペースの裏側
- 左右のキーマトリクスから等距離

---

### 5. バッテリーコネクタ（J_BATT）

**配置**: **裏面（B.Cu）** ⭐必須⭐

#### 理由
- バッテリーはケース内部に配置
- マイコンと同じ面で配線が短い
- 交換しやすい位置

#### 配置位置
- マイコンの近く
- ケース内に収まる位置

---

### 6. リセットスイッチ（SW_RST）⭐重要⭐

**配置**: **裏面（B.Cu）** ⭐推奨⭐

#### 理由
1. **マイコンが裏面にあるため**
   - マイコンのRSTピンに直接接続
   - 配線が短く済む

2. **使用頻度**
   - ファームウェア書き込み時のみ使用
   - 通常使用では押さない
   - 裏面でも問題ない

3. **ケース設計**
   - ボトムケースに小さな穴を開ける
   - ピンや細いドライバーでアクセス
   - または、ケースを外して押す

#### アクセス方法の選択肢

**オプション1: ボトムケースに穴を開ける**（推奨）
```
ボトムケース
    [穴 φ2-3mm]
        ↓
    リセットボタン（裏面）
        ↓
      PCB
```
- ピンや細いドライバーで押せる
- ファームウェア書き込み時に便利

**オプション2: ケースを外して押す**
- ボトムケースを外してアクセス
- 使用頻度が低いので許容範囲

**非推奨: 表面配置**
- マイコンが裏面にあると配線が長くなる
- ビアが必要で配線が複雑
- 表面のスペースを圧迫

---

### 7. パワースイッチ用コネクタ（J_SW: 2ピンヘッダー）⭐重要⭐

**配置**: **裏面（B.Cu）** ⭐推奨⭐

#### 理由
1. **ケース側装着のスイッチに接続**
   - 設計変更により、スイッチはケース側に装着
   - PCB側はコネクタのみ
   - ケース内配線で接続

2. **バッテリー系統と同じ面**
   - Battery+ → J_SW → (ケース内配線) → スイッチ → BATIN
   - すべて裏面で配線が完結
   - ビア不要

3. **配置位置**
   - バッテリーコネクタとマイコンの間
   - ケース側スイッチからの配線が届く位置

#### 回路経路
```
裏面の配置:
Battery+ (J_BATT Pin1) → [D_BATT] → J_SW Pin1
                                         ↓
                               (ケース内配線)
                                         ↓
                                   ケース側スイッチ
                                         ↓
                               (ケース内配線)
                                         ↓
J_SW Pin2 → BATIN (nice!nano Pin24,34)
```

#### コネクタの種類

**推奨: JST PH 2.0mm (B2B-PH-K)**
- バッテリーコネクタと同じシリーズ
- 着脱が容易
- 極性を間違えにくい

**代替案: 2ピンヘッダー（2.54mmピッチ）**
- 汎用的
- 低コスト
- ただし、極性を間違える可能性

---

### 8. デカップリングキャパシタ（C1～C5）

**配置**: **裏面（B.Cu）** ⭐推奨⭐

#### 理由
- マイコンが裏面にあるため
- マイコンの直近に配置する必要がある
- VCC/GND間に接続

#### 配置位置
- nice!nanoの四隅、5mm以内
- 裏面に配置すると配線が短い

---

### 9. プルアップ抵抗（R1: 10kΩ）

**配置**: **裏面（B.Cu）** ⭐推奨⭐

#### 理由
- リセット回路用
- マイコンとリセットスイッチが裏面にあるため
- VCC-RST間に接続

---

## 配置まとめ表

| 部品 | 記号 | 推奨配置 | 理由 |
|---|---|---|---|
| キースイッチ | SW1-42 | **表面** | ユーザー側に必要 |
| ダイオード | D1-42 | **表面** | スイッチの近く |
| LED | D43～ | **裏面** | リバースマウント |
| マイコン | U1 | **裏面** | 薄型化、中央配置 |
| バッテリーコネクタ | J_BATT | **裏面** | ケース内部 |
| **リセットスイッチ** | **SW_RST** | **裏面** | **マイコンの近く** |
| **スイッチ用コネクタ** | **J_SW** | **裏面** | **バッテリー系統** |
| デカップリングC | C1-5 | **裏面** | マイコンの近く |
| プルアップ抵抗 | R1 | **裏面** | リセット回路 |
| 保護ダイオード | D_BATT | **裏面** | バッテリー系統 |

---

## 実装手順

### ステップ1: 表面の部品配置
1. キースイッチのフットプリント配置
2. ダイオード配置
3. 配線（または裏面に引き回し）

### ステップ2: 裏面の部品配置
1. マイコンを中央スペースに配置（`F`キーでフリップ）
2. バッテリーコネクタ配置（`F`キーでフリップ）
3. **リセットスイッチ配置**（`F`キーでフリップ）
4. **スイッチ用コネクタ（J_SW）配置**（`F`キーでフリップ）
5. デカップリングキャパシタ配置
6. LED配置（リバースマウント）

### ステップ3: ビアで表裏接続
1. COL/ROW信号をビアで裏面に引き出し
2. VCC/GNDプレーンを両面に配置

### ステップ4: 配線
1. 裏面の部品同士を配線
2. 表面のマトリクス配線
3. ビア経由で表裏を接続

---

## ケース設計への影響

### ボトムケース設計時の考慮事項

#### 1. リセットスイッチのアクセス穴
```
推奨仕様:
- 穴径: φ2～3mm
- 位置: リセットスイッチの真下
- 深さ: ボトムケースの厚み分
```

#### 2. マイコンのクリアランス
- nice!nanoの高さ: 約8～10mm（ピンヘッダー含む）
- ボトムケースの深さ: 最低10mm以上

#### 3. USB穴
- ケース背面または側面
- マイコンのUSBポート位置に合わせる

#### 4. バッテリースペース
- Li-Poバッテリー（301230）: 約3mm厚
- マイコンと干渉しない位置

---

## チェックリスト

### 配置確認
- [ ] キースイッチ: 表面
- [ ] ダイオード: 表面
- [ ] マイコン: 裏面中央
- [ ] バッテリーコネクタ: 裏面
- [ ] **リセットスイッチ: 裏面**
- [ ] **スイッチ用コネクタ（J_SW）: 裏面**
- [ ] デカップリングキャパシタ: 裏面（マイコン近く）
- [ ] LED: 裏面（リバースマウント）

### ケース設計確認
- [ ] ボトムケースにリセット用穴（φ2-3mm）
- [ ] マイコンのクリアランス確保（10mm以上）
- [ ] USB穴の位置確認
- [ ] バッテリースペース確保

---

## トラブルシューティング

### Q: リセットスイッチを表面に配置したい
A: 可能ですが、以下の理由で非推奨：
- マイコンが裏面にあると配線が長くなる
- ビアが必要で配線が複雑
- 表面のスペースを圧迫
- 誤押しのリスク

### Q: スイッチ用コネクタ（J_SW）を表面に配置できる？
A: 技術的には可能ですが、非推奨：
- バッテリー系統がすべて裏面にあるため、配線が複雑
- ビアが増える
- 裏面配置の方が配線がシンプル

### Q: ボトムケースに穴を開けたくない
A: 以下の方法があります：
1. ケースを外してリセットスイッチを押す（使用頻度低いので許容）
2. ファームウェアでソフトリセット機能を実装
3. USBケーブルを抜き差しして再起動

---

## まとめ

### 重要な配置決定

**リセットスイッチ（SW_RST）: 裏面**
- マイコンと同じ面で配線が短い
- ボトムケースに小さな穴を開けてアクセス
- または、ケースを外して押す

**スイッチ用コネクタ（J_SW）: 裏面**
- バッテリー系統と同じ面
- ケース側装着のスイッチと配線で接続
- 配線がシンプル

この配置により、表面はキースイッチのみのクリーンな設計となり、裏面に機能部品を集約できます。
