takunii/mami-kbd/doc/mcu-placement-guide.md

# マイコン配置ガイド - 表面 vs 裏面

このドキュメントでは、キーボード設計におけるマイコン（nice!nano等）の配置について説明します。

---

## 結論: どちらも一般的です

**マイコンを裏面に配置することは非常に一般的**で、多くのキーボード設計で採用されています。表面・裏面のどちらにも長所と短所があり、設計目標に応じて選択します。

---

## 配置パターンの比較

### パターン1: 表面（トップ側）実装

マイコンをキースイッチと同じ側（F.Cu面）に配置

#### メリット
- **組み立てが簡単**: すべての部品が一方向から見える
- **デバッグが容易**: USB接続やリセットボタンが表から見える
- **配線が短い**: キーマトリクスとの配線距離が短い
- **一般的な構造**: 初心者向けキットに多い

#### デメリット
- **厚みが増す**: マイコンの高さ分（約3～5mm）ケースが厚くなる
- **スペース確保が必要**: キースイッチの配置に制約
- **見た目**: マイコンが目立つ（好みによる）
- **ケース設計**: マイコン用の開口部や空間が必要

#### 向いているケース
- 通常の高さのキーボード
- 初心者向け設計
- マイコンへのアクセスが頻繁に必要
- ケースなしの露出設計

---

### パターン2: 裏面（ボトム側）実装 ⭐多くの設計で採用⭐

マイコンをキースイッチの反対側（B.Cu面）に配置

#### メリット
- **薄型化**: キースイッチ側の高さを最小限に
- **ロープロファイル**: 薄型キーボード設計に最適
- **見た目がスッキリ**: 表面がキースイッチのみで美しい
- **スペース効率**: キースイッチの配置に制約が少ない
- **保護**: マイコンがケースで保護される

#### デメリット
- **組み立てが複雑**: 裏返しての作業が必要
- **デバッグが難しい**: USB接続やリセットボタンが見えにくい
- **配線が長い**: ビアを多用する必要がある
- **ケース設計**: マイコン用のクリアランス確保が必要

#### 向いているケース
- **ロープロファイル/薄型キーボード** ⭐最適⭐
- 美しい見た目を重視
- ケース付き設計
- スペース効率を重視

---

## nice!nanoの場合

### 一般的な実装方法

**裏面実装が主流**です。理由：

1. **Bluetooth無線モジュール**
   - nice!nanoはBLE（Bluetooth Low Energy）を搭載
   - 無線設計では薄型化が重要
   - 裏面実装により、表面はキーだけのクリーンな設計に

2. **Pro Microとの互換性**
   - Pro Microの代替として設計されている
   - 多くのPro Micro用基板は裏面実装を想定

3. **バッテリー配置**
   - Li-Poバッテリーも裏面に配置することが多い
   - マイコンとバッテリーを同じ面にすると配線が簡単

### nice!nano裏面実装の例

多くの人気キーボード設計で採用：
- **Corne (crkbd)**: 裏面実装
- **Lily58**: 裏面実装
- **Sofle**: 裏面実装  
- **Kyria**: 裏面実装

---

## 実装方法の詳細

### 裏面実装の手順

#### 1. PCB設計時
```
F.Cu (表面)
  ├── キースイッチ（SW1-SW42）
  ├── ダイオード（D1-D42）
  └── LED（オプション）

B.Cu (裏面)
  ├── nice!nano（U1）
  ├── バッテリーコネクタ（J_BATT）
  ├── スイッチ用コネクタ（J_SW）
  └── リセットボタン（SW_RST）
```

#### 2. フットプリント配置
- nice!nanoのフットプリントを「B.Cu」レイヤーに配置
- または、表面に配置してから `F`キー（Flip）で裏返す

#### 3. 配線
- **ビア（Via）**を使用してF.Cu ⟷ B.Cu間を接続
- COL/ROW信号はビアで裏面に引き出し
- VCC/GNDはベタグランド/プレーンで接続

#### 4. ピンヘッダーの向き
```
裏面実装の場合:
  
裏面 (B.Cu)           表面 (F.Cu)
[nice!nano]    →     [キースイッチ]
    ↑                      ↑
 ピンヘッダー          スルーホール
 (上向き)              (貫通)
```

- コンスルー（スプリングピンヘッダー）推奨
- はんだ付け不要で着脱可能

---

## 設計時の注意点

### 裏面実装時の考慮事項

#### 1. ケースのクリアランス
- nice!nanoの厚み: 約**3～5mm**
- ピンヘッダーを含めると: 約**8～10mm**
- ケース設計時に十分な空間を確保

#### 2. USB接続
- **USB-Cポート**を外部から接続できるようにする
- オプション:
  - ケースに開口部を設ける
  - USB延長ケーブルを使用
  - ケース側にUSBコネクタを配置

#### 3. スイッチ・バッテリー配置
- パワースイッチ: ケース側またはPCB裏面
- バッテリー: PCB裏面に配置が一般的
- リセットボタン: 裏面に配置（アクセス用の穴を開ける）

#### 4. 配線の長さ
- 裏面実装では配線が長くなる可能性
- ビアを適切に配置して最短経路を確保
- グランドプレーンを裏面にも配置

---

## mami42の推奨配置

### mami42の仕様
- **レイアウト**: Aliceレイアウト（一体型、非分割）
- **キー数**: 42キー
- **キースイッチ**: Cherry Profile（通常の高さ）
- **マイコン**: nrf52840開発ボード（nice!nano互換）
- **特徴**: 左右が角度を持って配置されたエルゴノミクスキーボード

### Aliceキーボードでのマイコン配置の特徴

Aliceレイアウトは一体型のため、マイコンの配置場所に選択肢があります：

#### オプション1: 中央スペース部分（表面または裏面）
- Aliceレイアウトの左右キー群の間には**中央スペース**がある
- ここにマイコンを配置するのが一般的
- 表面でも裏面でも配線が比較的短く済む

#### オプション2: 裏面中央（推奨）⭐

```
表面 (F.Cu) - ユーザーから見える側
━━━━━━━━━━━━━━━━━━━━━━━━━━━━━━━━━
  🔲 🔲 🔲 🔲     中央スペース      🔲 🔲 🔲 🔲
  🔲 🔲 🔲         (空きスペース)      🔲 🔲 🔲
  🔲 🔲 🔲 🔲        ↓              🔲 🔲 🔲 🔲
  💡 💡 💡 💡    (マイコン配置)     💡 💡 💡 💡  ← LED
━━━━━━━━━━━━━━━━━━━━━━━━━━━━━━━━━

裏面 (B.Cu) - ケース内側
━━━━━━━━━━━━━━━━━━━━━━━━━━━━━━━━━
                📡 nrf52840           ← マイコン（中央）
                🔋 バッテリー         ← Li-Po
                🔌 コネクタ類         ← スイッチ用等
                🔲 リセットボタン     ← アクセス用穴
━━━━━━━━━━━━━━━━━━━━━━━━━━━━━━━━━
```

**Aliceレイアウト + Cherry Profile の場合の推奨**:
- **裏面中央配置**が最適
- Cherry Profileは高さがあるため、裏面実装でもケース内に余裕がある
- 左右のキーマトリクスへの配線距離が均等
- USB接続をケース背面または側面に配置しやすい

---

## 実装例の参考

### オープンソースキーボード設計

1. **Corne (crkbd)**
   - nice!nano: 裏面実装
   - バッテリー: 裏面
   - スタイル: ロープロファイル

2. **Lily58**
   - Pro Micro/nice!nano: 裏面実装
   - OLEDディスプレイ: 表面

3. **Sofle RGB**
   - Pro Micro/nice!nano: 裏面実装
   - RGB LED: 裏面（リバースマウント）

これらの設計を参考にすると良いでしょう。

---

## チェックリスト

### 裏面実装を選択する場合

- [ ] ケースに十分なクリアランス（8～10mm）がある
- [ ] USB接続のアクセス方法を決定
- [ ] リセットボタンのアクセス方法を決定（穴を開ける等）
- [ ] バッテリーと同じ面に配置
- [ ] ビアを適切に配置して配線経路を確保
- [ ] グランドプレーンを裏面にも配置

### 表面実装を選択する場合

- [ ] ケースの高さに余裕がある
- [ ] マイコン用のスペースを確保
- [ ] USB/リセットボタンへの簡単なアクセス
- [ ] 初心者向け/デバッグ重視の設計

---

## まとめ

**質問への回答**:
> マイコンをPCBの裏側に設置することが一般的ですか？

**はい、非常に一般的です**。特に：
- ロープロファイル/薄型キーボード
- 無線キーボード（nice!nano等）
- 美しい見た目を重視する設計

では、**裏面実装が標準**です。

mami42のようなAliceレイアウトキーボード（一体型、42キー）であれば、**裏面中央配置を推奨**します。Cherry Profileの高さがあるため裏面実装でも問題なく、中央配置により左右のキーマトリクスへの配線が均等になります。バッテリーと合わせて実装することで配線もシンプルになります。
