takunii/mami-kbd/step/v3.3/bottom_case_techview.pdf

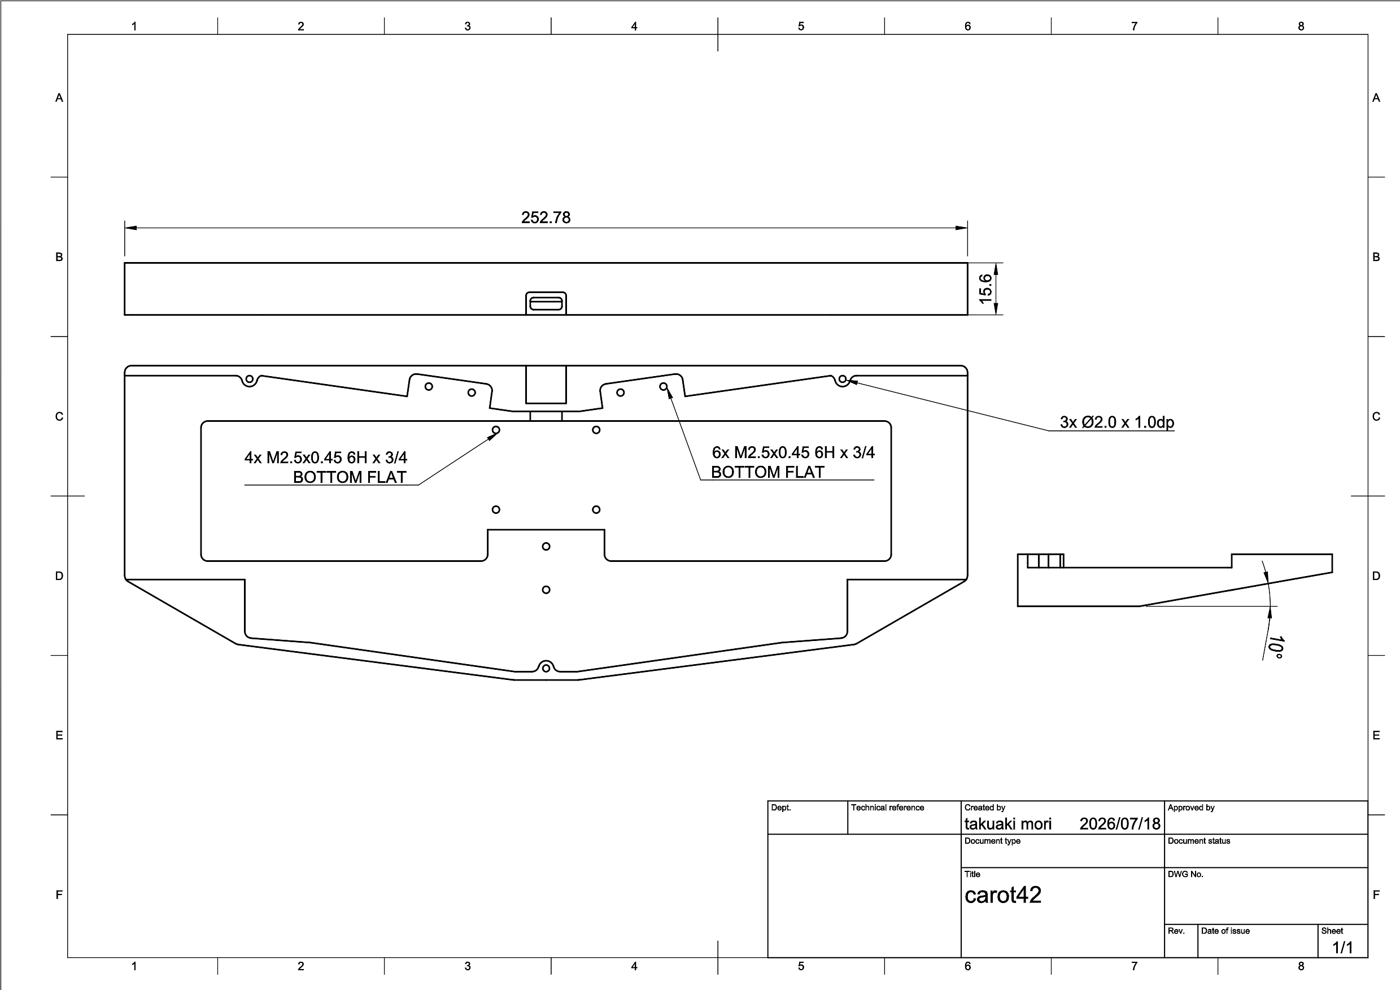
[picture p27: page 1]
