takunii/mami-kbd/step/v3.3/top_case_techview.pdf

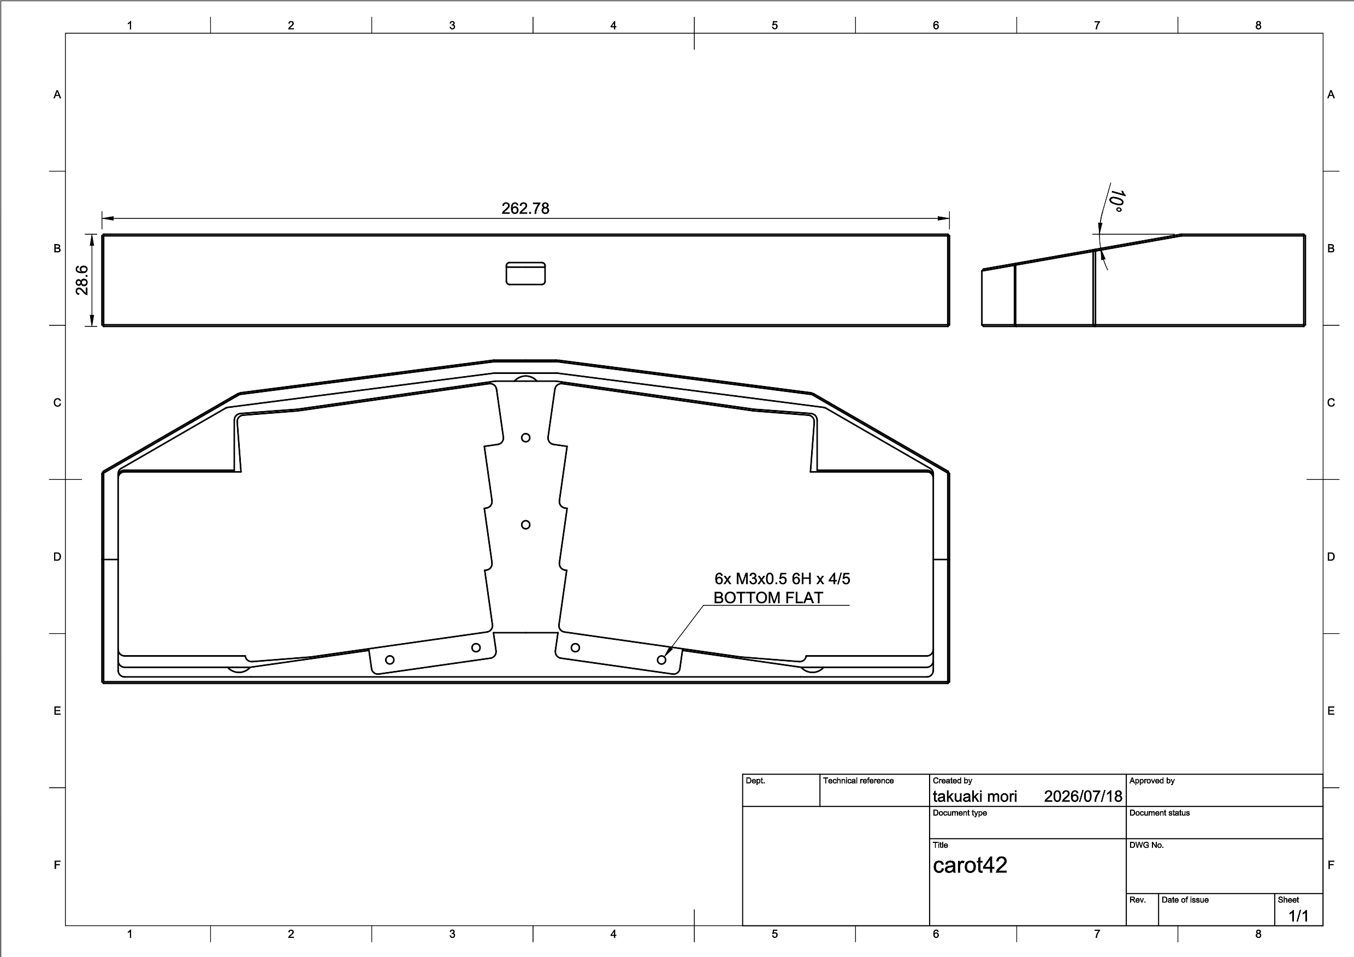
[picture p28: page 1]
