takunii/mami-kbd/step/v3.5_screw/carot42_v3.5_top_case_techview.pdf

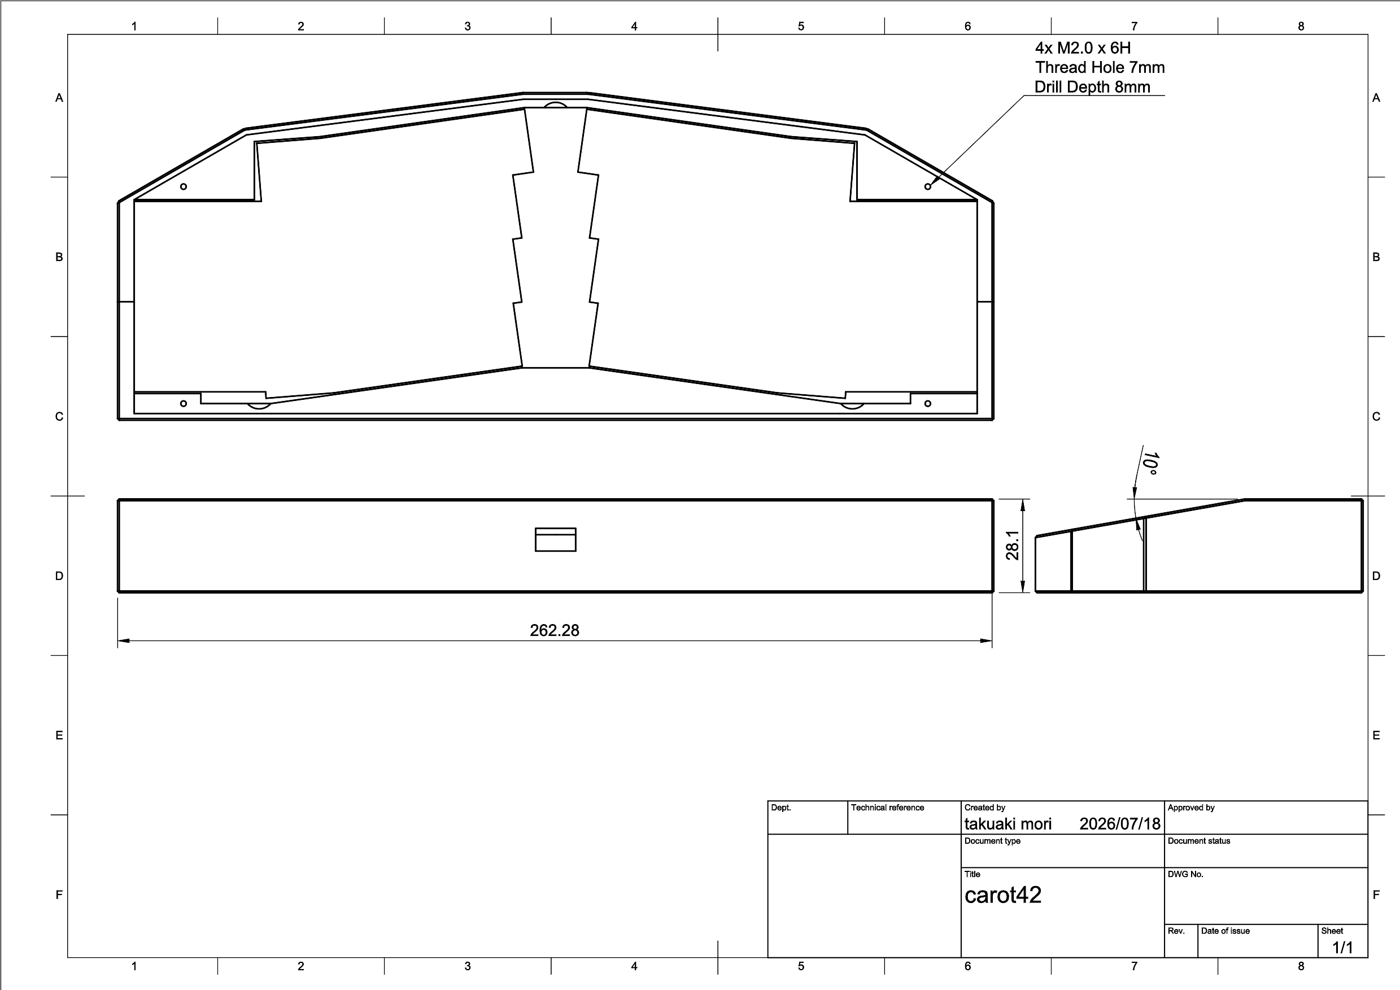
[picture p29: page 1]
