takunii/mami-kbd/step/v3.5_screw/screw_bottom_techview.pdf

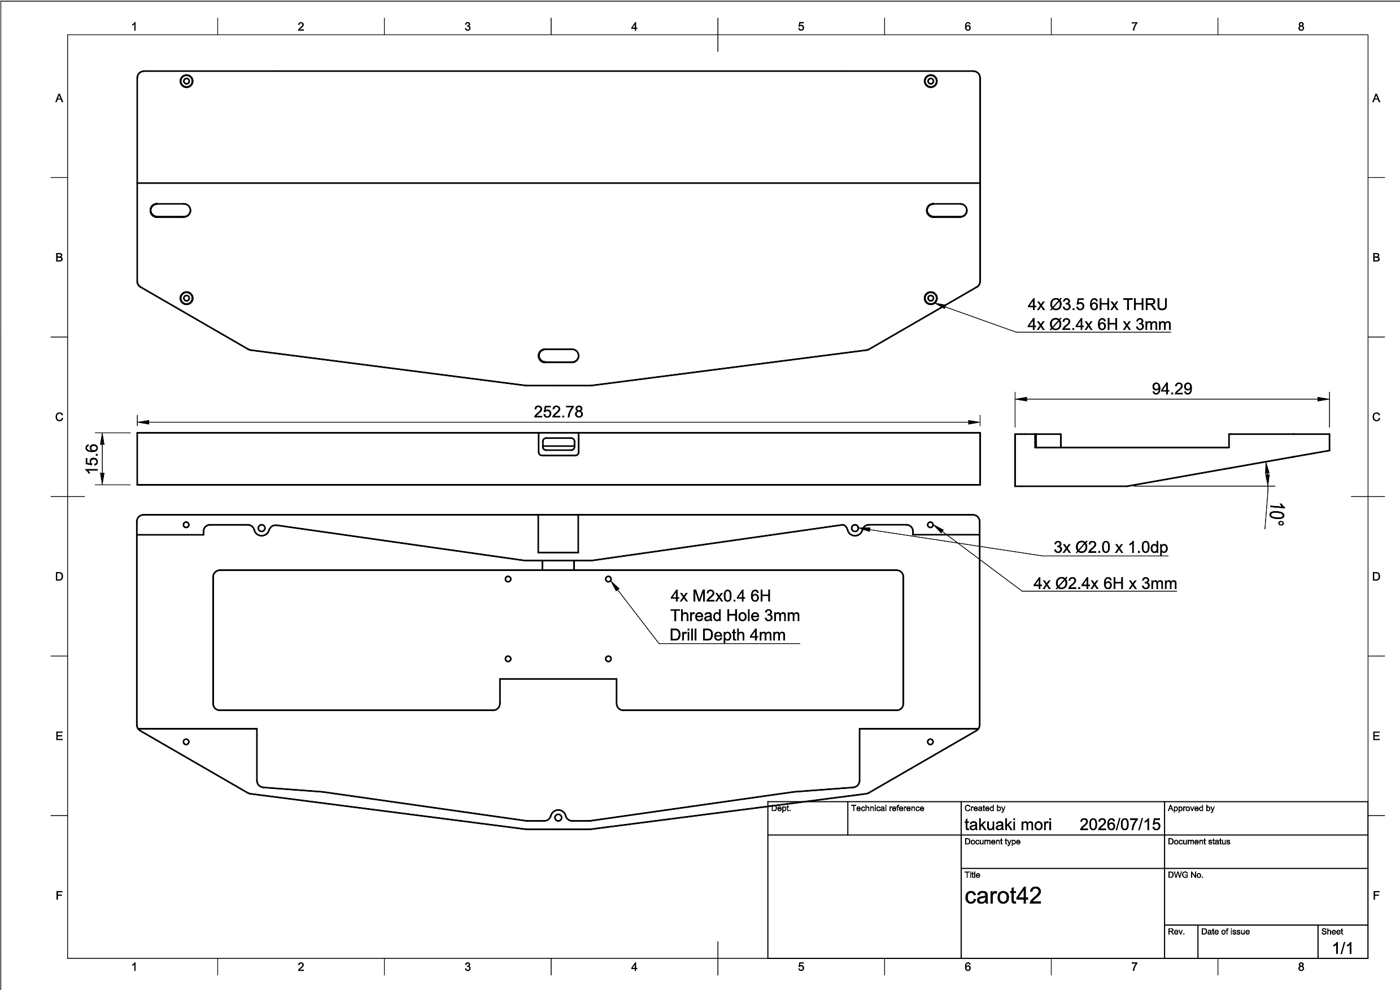
[picture p30: page 1]
