takunii/mami-kbd/step/v3/carat42_v3_bottom_techview.pdf

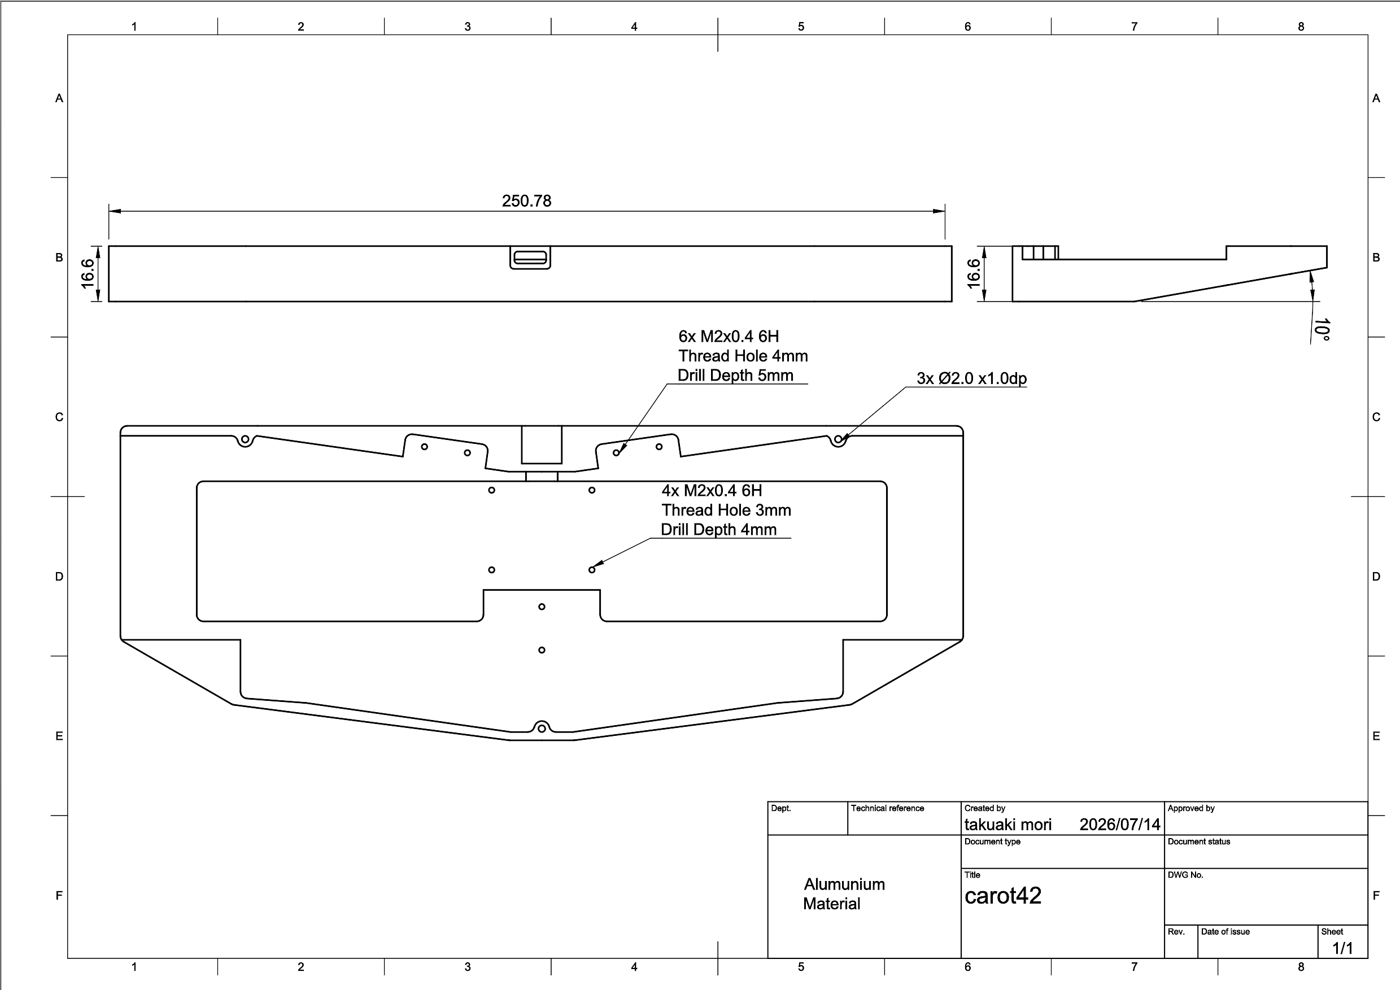
[picture p31: page 1]
