takunii/mami-kbd/step/v3/carot42_screw_top_techview.pdf

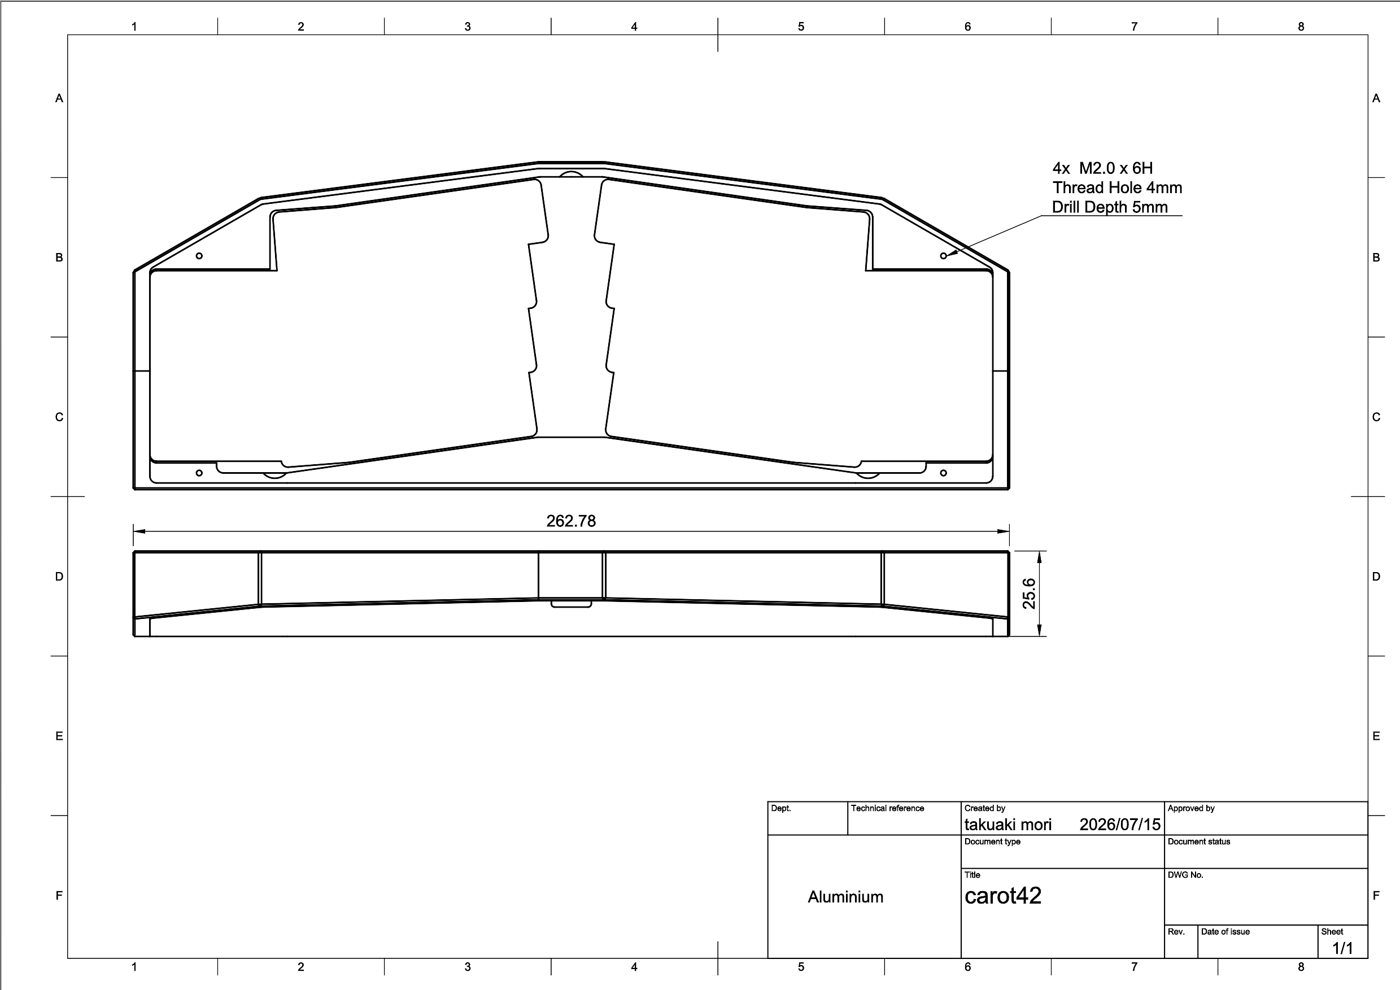
[picture p32: page 1]
