takunii/mami-kbd/step/v3/carot42_v3_top_techview.pdf

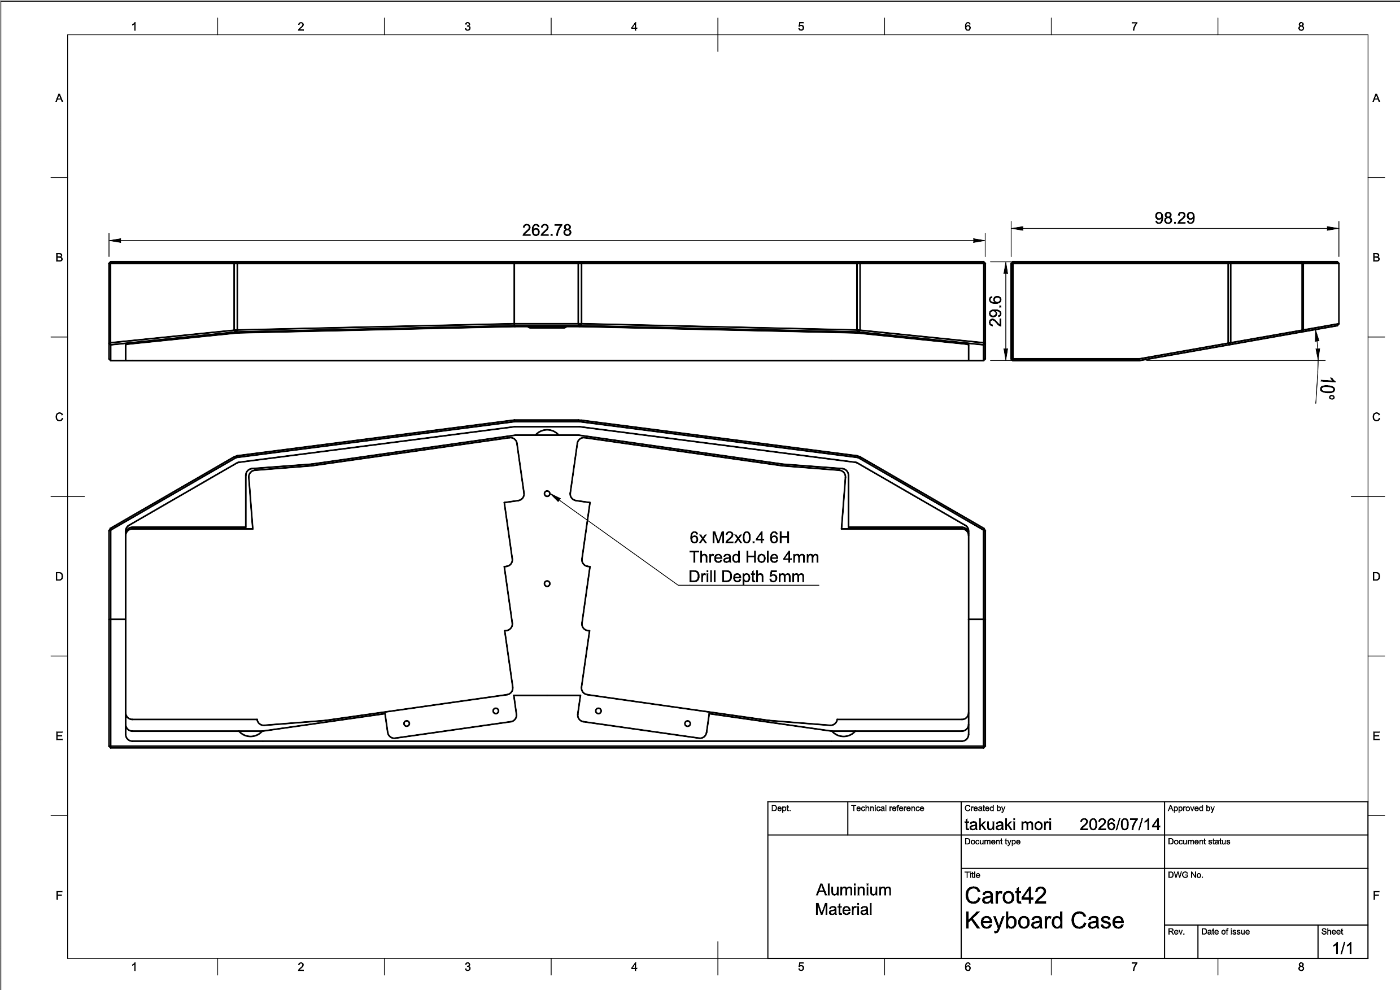
[picture p33: page 1]
