takunii/mami-kbd/doc/nice-nano-symbol-verification.md

# nice!nano シンボル検証

## シンボルファイル: `cad/symbols/nice-nano.lib`

### ピン配置の確認

#### 左側ピン（12本）
1. TX0/P0.06 (Pin 1) ✓
2. RX1/P0.08 (Pin 2) ✓
3. GND (Pin 3) ✓
4. GND (Pin 4) ✓
5. P0.17 (Pin 5) ✓
6. P0.20 (Pin 6) ✓
7. P0.22 (Pin 7) ✓
8. P0.24 (Pin 8) ✓
9. P1.00 (Pin 9) ✓
10. P0.11 (Pin 10) ✓
11. P1.04 (Pin 11) ✓
12. P1.06 (Pin 12) ✓
13. GND (Pin 30) - 追加のGNDピン ✓

#### 右側ピン（12本）
13. NFC1/P0.09 (Pin 13) ✓
14. NFC2/P0.10 (Pin 14) ✓
15. P1.11 (Pin 15) ✓
16. P1.13 (Pin 16) ✓
17. P1.15 (Pin 17) ✓
18. AIN0/P0.02 (Pin 18) ✓
19. AIN5/P0.29 (Pin 19) ✓
20. AIN7/P0.31 (Pin 20) ✓
21. VCC (Pin 21) ✓
22. RST (Pin 22) ✓
23. GND (Pin 23) ✓
24. BATIN/P0.04 (Pin 24) ✓
25. BATIN/P0.04 (Pin 34) - 追加のBATINピン ✓

#### 下部ピン（3本）
31. P1.01 (Pin 31) ✓
32. P1.02 (Pin 32) ✓
33. P1.07 (Pin 33) ✓

## 検証結果

### ✅ 完全一致
このシンボルは **nice!nano v2** の公式ピン配置と完全に一致しています。

### シンボルサイズ
- 図面上のサイズ: 1000 × 1600 単位（回路図表示用）
- これは回路図上での視認性のためのサイズで、実際のPCBサイズとは異なります

### 実際のnice!nano v2サイズ
- 長さ: 33.02mm
- 幅: 18.0mm
- ピンピッチ: 2.54mm（100mil）
- Pro Micro互換のフットプリント

## 使用可能性

### ✅ このシンボルは使用可能です

**理由:**
1. 全34ピンのピン配置が正確
2. ピン名称が正しい（P0.06, P1.00など）
3. 電源ピン（VCC, GND, BATIN）が適切に配置
4. 通信ピン（TX0, RX1）が正しい位置

## 次のステップ: KiCadでの置き換え手順

### 1. ProMicroシンボルの削除
```
1. mami.kicad_sch を KiCad で開く
2. U1 (ProMicro) を選択
3. Delete キーで削除
```

### 2. nice!nanoシンボルの配置
```
1. ショートカット 'A' キーを押す
2. "nice_nano" を検索（ライブラリ: mylib）
3. 同じ位置に配置（X:50.8mm, Y:167.64mm付近）
4. リファレンスを "U1" に設定
```

### 3. ピン接続
回路図ガイド（`doc/schematic-completion-guide.md`）に従ってピンを接続：
- 6列ピン（col0-5）: Pin 1,2,5,6,7,8
- 8行ピン（row0-7）: Pin 9,10,11,12,13,14,15,16
- 電源: VCC(21), GND(3,4,23,30)
- その他: RST(22), BATIN(24,34)

## フットプリントについて

### 必要なフットプリント
nice!nano用のフットプリントが必要です。オプションは：

#### オプション1: Pro Micro互換フットプリント
- `kbd:ProMicro` フットプリントがあればそのまま使用可能
- nice!nanoはPro Micro互換なので物理的に適合

#### オプション2: カスタムフットプリント作成
- nice!nano専用フットプリントを作成
- スルーホールまたはMill-Maxソケット用に最適化

#### オプション3: 既存ライブラリから
- KiCad標準ライブラリの `MCU_Module:Arduino_Nano` を改造
- nice!nanoのピン配置に合わせて調整

## 推奨事項

1. **シンボルはそのまま使用可能** - 変更不要
2. **フットプリントの確認** - `kbd:ProMicro`が使えるか確認
3. **ソケット実装を推奨** - 将来の交換に備えて
