takunii/mami-kbd/cad/mami-User_Drawings.pdf

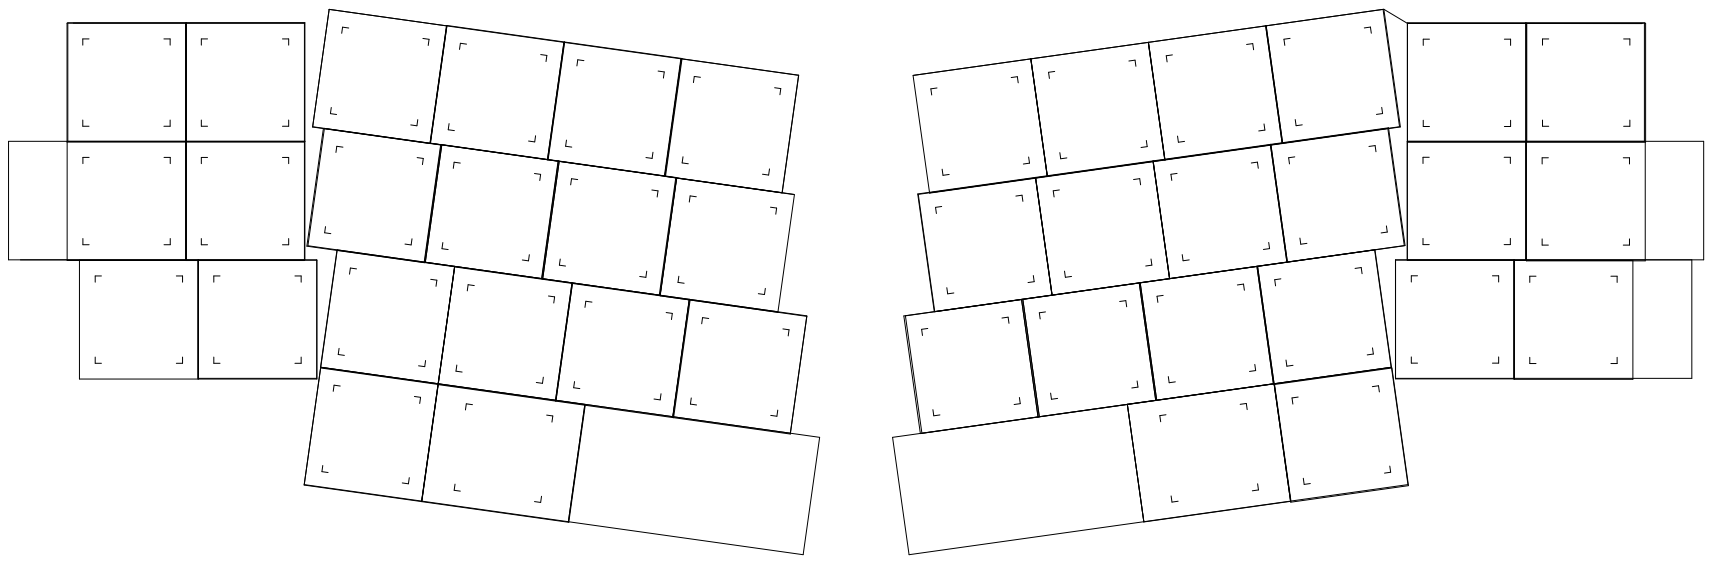
[picture p34: page 1]
