takunii/mami-kbd/(list of files, drawings)

Other design files:
routing/mami.dsn
routing/routing_260611.dsn
routing/routing_260612.dsn
routing/routing_260613.dsn
