takunii/mami-kbd/cad/_restore_backup_2026-07-20T22-31-31-266/mami.kicad_pcb

## KiCad design cad/_restore_backup_2026-07-20T22-31-31-266/mami.kicad_pcb (2026-08-04)

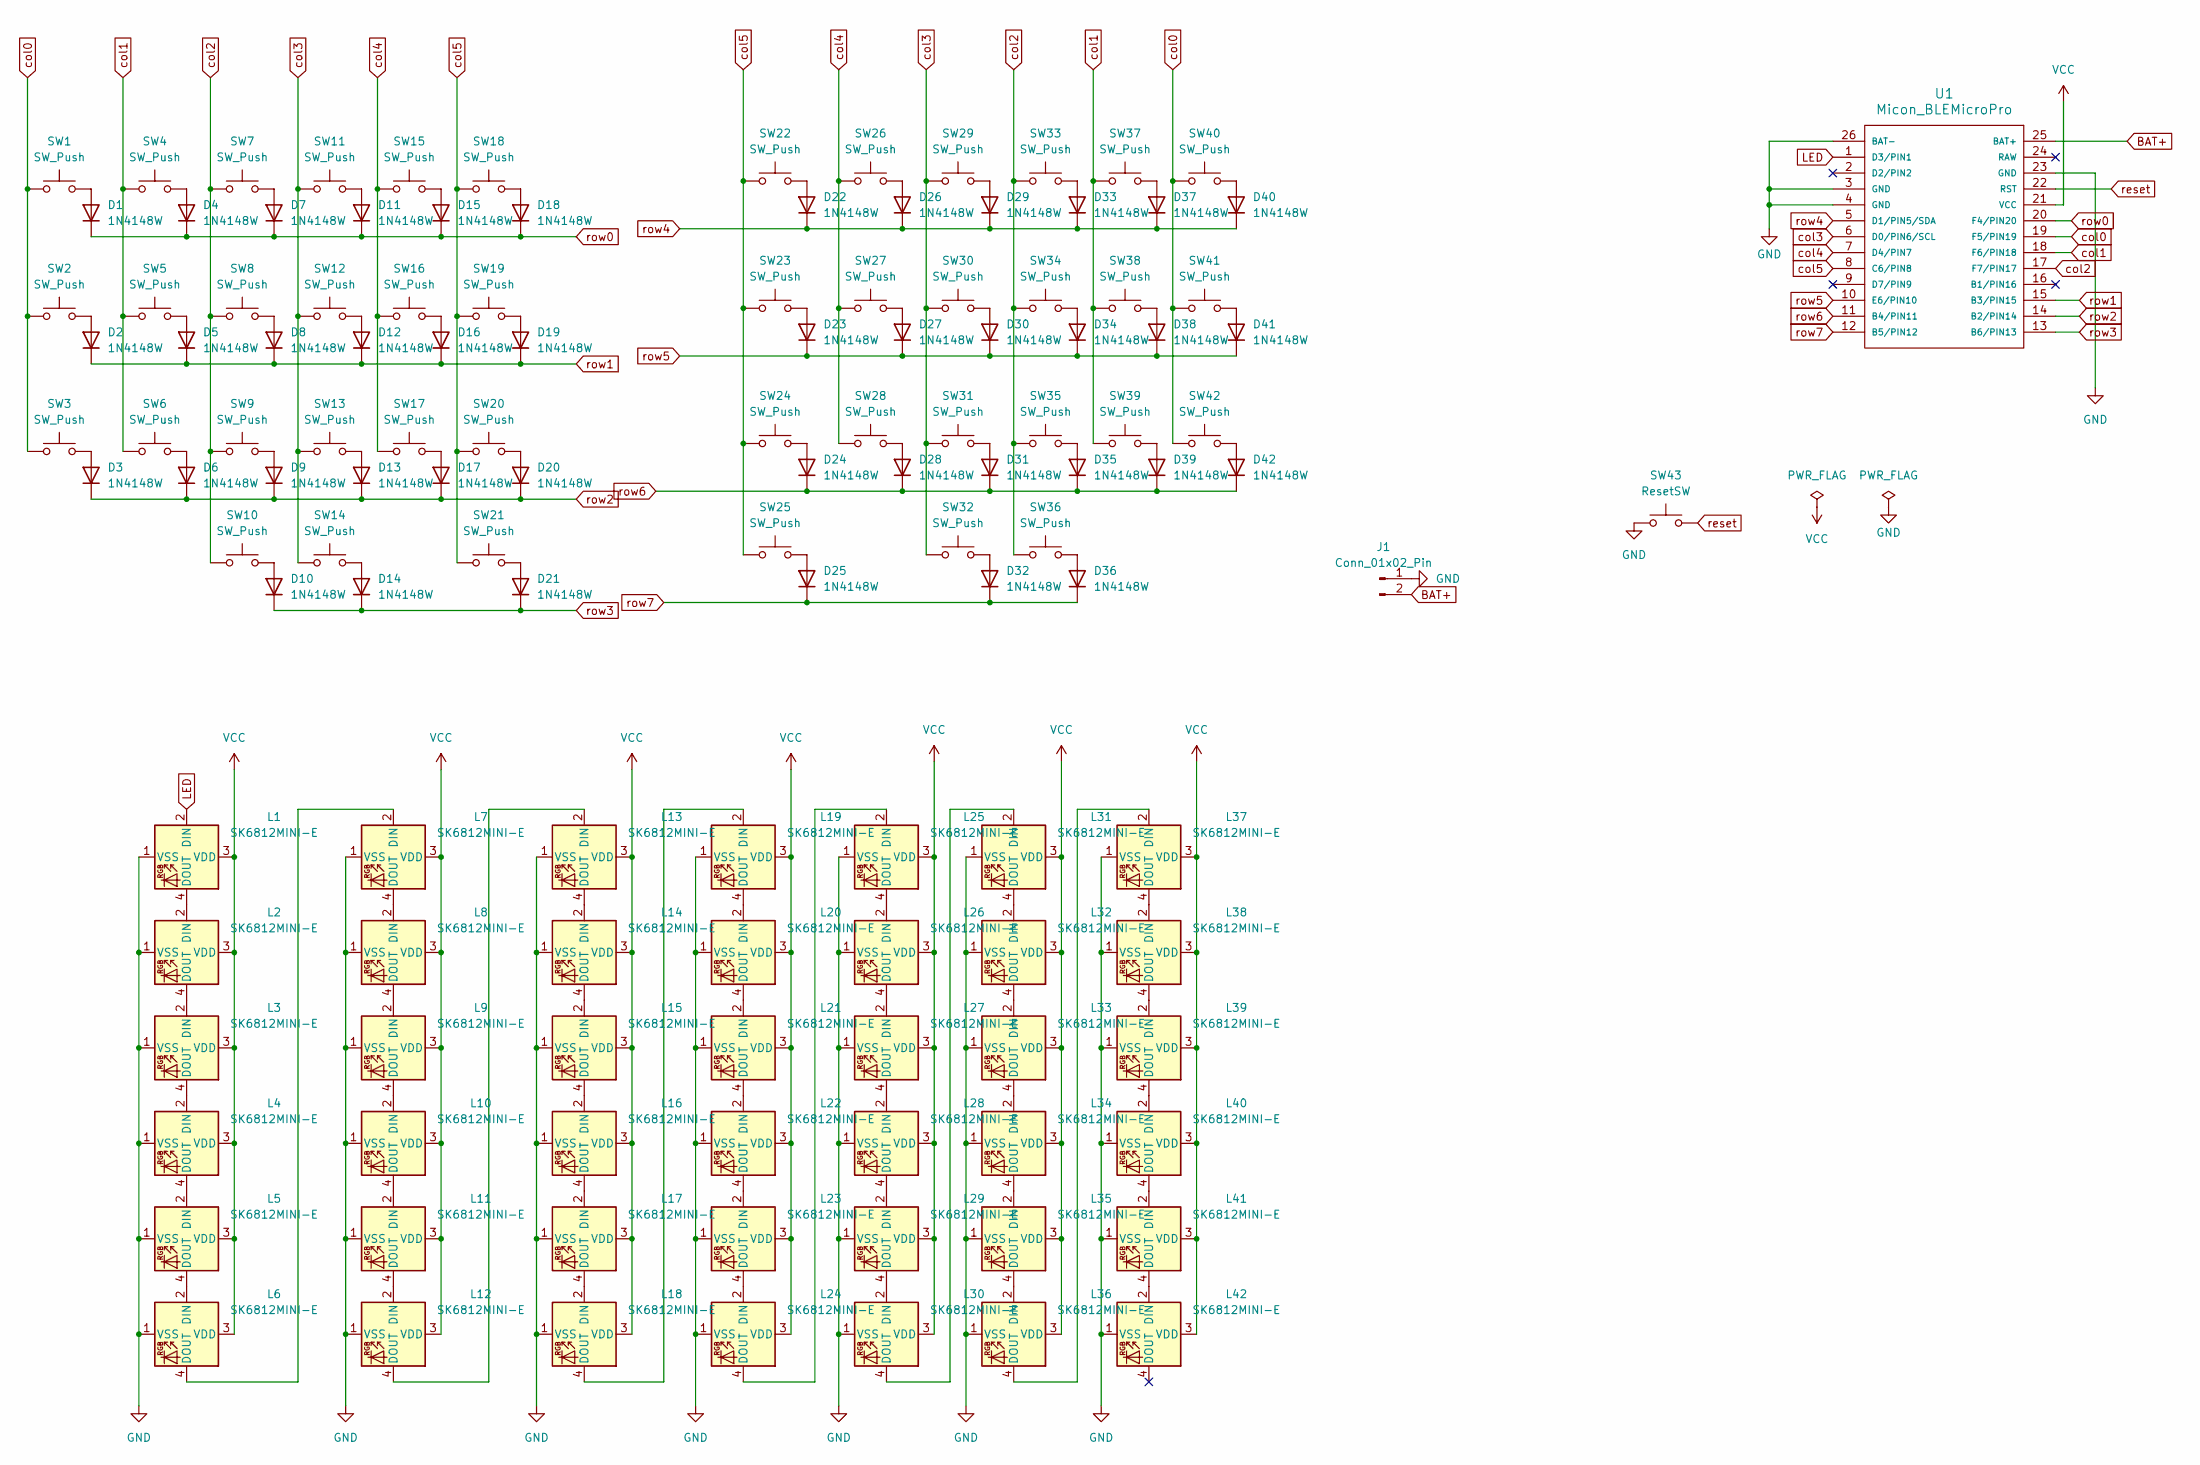
[picture p35: schematic mami.kicad_sch]

Parts:
D1, D2, D3, D4, D5, D6, D7, D8, D9, D10, D11, D12, D13, D14, D15, D16, D17, D18, D19, D20, D21, D22, D23, D24, D25, D26, D27, D28, D29, D30, D31, D32, D33, D34, D35, D36, D37, D38, D39, D40, D41, D42: 1N4148W; Diode_SMD
J1: Conn_01x02_Pin; Battery_BMP_2pin
L1, L2, L3, L4, L5, L6, L7, L8, L9, L10, L11, L12, L13, L14, L15, L16, L17, L18, L19, L20, L21, L22, L23, L24, L25, L26, L27, L28, L29, L30, L31, L32, L33, L34, L35, L36, L37, L38, L39, L40, L41, L42: SK6812MINI-E; LED_SK6812MINI-E_BL
SW1, SW2, SW3, SW4, SW5, SW6, SW7, SW8, SW9, SW10, SW11, SW12, SW13, SW15, SW16, SW17, SW18, SW19, SW20, SW22, SW23, SW24, SW26, SW27, SW28, SW29, SW30, SW31, SW33, SW34, SW35, SW36, SW37, SW38, SW39, SW40, SW41, SW42: SW_Push; CherryMX_Hotswap_1u
SW14, SW32: SW_Push; CherryMX_Hotswap_1.25u
SW21, SW25: SW_Push; CherryMX_Hotswap_2u
SW43: ResetSW
U1: Micon_BLEMicroPro; Micon_BMP_7sKB

Connections:
BAT+: J1.2, U1.25 (BAT+)
GND: J1.1, L1.1 (VSS), L2.1 (VSS), L3.1 (VSS), L4.1 (VSS), L5.1 (VSS), L6.1 (VSS), L7.1 (VSS), L8.1 (VSS), L9.1 (VSS), L10.1 (VSS), L11.1 (VSS), L12.1 (VSS), L13.1 (VSS), L14.1 (VSS), L15.1 (VSS), L16.1 (VSS), L17.1 (VSS), L18.1 (VSS), L19.1 (VSS), L20.1 (VSS), L21.1 (VSS), L22.1 (VSS), L23.1 (VSS), L24.1 (VSS), L25.1 (VSS), L26.1 (VSS), L27.1 (VSS), L28.1 (VSS), L29.1 (VSS), L30.1 (VSS), L31.1 (VSS), L32.1 (VSS), L33.1 (VSS), L34.1 (VSS), L35.1 (VSS), L36.1 (VSS), L37.1 (VSS), L38.1 (VSS), L39.1 (VSS), L40.1 (VSS), L41.1 (VSS), L42.1 (VSS), SW43.1, U1.3 (GND), U1.4 (GND), U1.23 (GND), U1.26 (BAT-)
LED: L1.2 (DIN), U1.1 (D3/PIN1)
unnamed: D1.2 (A), SW1.2
unnamed: D2.2 (A), SW2.2
unnamed: D3.2 (A), SW3.2
unnamed: D4.2 (A), SW4.2
unnamed: D5.2 (A), SW5.2
unnamed: D6.2 (A), SW6.2
unnamed: D7.2 (A), SW7.2
unnamed: D8.2 (A), SW8.2
unnamed: D9.2 (A), SW9.2
unnamed: D10.2 (A), SW10.2
unnamed: D11.2 (A), SW11.2
unnamed: D12.2 (A), SW12.2
unnamed: D13.2 (A), SW13.2
unnamed: D14.2 (A), SW14.2
unnamed: D15.2 (A), SW15.2
unnamed: D16.2 (A), SW16.2
unnamed: D17.2 (A), SW17.2
unnamed: D18.2 (A), SW18.2
unnamed: D19.2 (A), SW19.2
unnamed: D20.2 (A), SW20.2
unnamed: D21.2 (A), SW21.2
unnamed: D22.2 (A), SW22.2
unnamed: D23.2 (A), SW23.2
unnamed: D24.2 (A), SW24.2
unnamed: D25.2 (A), SW25.2
unnamed: D26.2 (A), SW26.2
unnamed: D27.2 (A), SW27.2
unnamed: D28.2 (A), SW28.2
unnamed: D29.2 (A), SW29.2
unnamed: D30.2 (A), SW30.2
unnamed: D31.2 (A), SW31.2
unnamed: D32.2 (A), SW32.2
unnamed: D33.2 (A), SW33.2
unnamed: D34.2 (A), SW34.2
unnamed: D35.2 (A), SW35.2
unnamed: D36.2 (A), SW36.2
unnamed: D37.2 (A), SW37.2
unnamed: D38.2 (A), SW38.2
unnamed: D39.2 (A), SW39.2
unnamed: D40.2 (A), SW40.2
unnamed: D41.2 (A), SW41.2
unnamed: D42.2 (A), SW42.2
unnamed: L1.4 (DOUT), L2.2 (DIN)
unnamed: L2.4 (DOUT), L3.2 (DIN)
unnamed: L3.4 (DOUT), L4.2 (DIN)
unnamed: L4.4 (DOUT), L5.2 (DIN)
unnamed: L5.4 (DOUT), L6.2 (DIN)
unnamed: L6.4 (DOUT), L7.2 (DIN)
unnamed: L7.4 (DOUT), L8.2 (DIN)
unnamed: L8.4 (DOUT), L9.2 (DIN)
unnamed: L9.4 (DOUT), L10.2 (DIN)
unnamed: L10.4 (DOUT), L11.2 (DIN)
unnamed: L11.4 (DOUT), L12.2 (DIN)
unnamed: L12.4 (DOUT), L13.2 (DIN)
unnamed: L13.4 (DOUT), L14.2 (DIN)
unnamed: L14.4 (DOUT), L15.2 (DIN)
unnamed: L15.4 (DOUT), L16.2 (DIN)
unnamed: L16.4 (DOUT), L17.2 (DIN)
unnamed: L17.4 (DOUT), L18.2 (DIN)
unnamed: L18.4 (DOUT), L19.2 (DIN)
unnamed: L19.4 (DOUT), L20.2 (DIN)
unnamed: L20.4 (DOUT), L21.2 (DIN)
unnamed: L21.4 (DOUT), L22.2 (DIN)
unnamed: L22.4 (DOUT), L23.2 (DIN)
unnamed: L23.4 (DOUT), L24.2 (DIN)
unnamed: L24.4 (DOUT), L25.2 (DIN)
unnamed: L25.4 (DOUT), L26.2 (DIN)
unnamed: L26.4 (DOUT), L27.2 (DIN)
unnamed: L27.4 (DOUT), L28.2 (DIN)
unnamed: L28.4 (DOUT), L29.2 (DIN)
unnamed: L29.4 (DOUT), L30.2 (DIN)
unnamed: L30.4 (DOUT), L31.2 (DIN)
unnamed: L31.4 (DOUT), L32.2 (DIN)
unnamed: L32.4 (DOUT), L33.2 (DIN)
unnamed: L33.4 (DOUT), L34.2 (DIN)
unnamed: L34.4 (DOUT), L35.2 (DIN)
unnamed: L35.4 (DOUT), L36.2 (DIN)
unnamed: L36.4 (DOUT), L37.2 (DIN)
unnamed: L37.4 (DOUT), L38.2 (DIN)
unnamed: L38.4 (DOUT), L39.2 (DIN)
unnamed: L39.4 (DOUT), L40.2 (DIN)
unnamed: L40.4 (DOUT), L41.2 (DIN)
unnamed: L41.4 (DOUT), L42.2 (DIN)
VCC: L1.3 (VDD), L2.3 (VDD), L3.3 (VDD), L4.3 (VDD), L5.3 (VDD), L6.3 (VDD), L7.3 (VDD), L8.3 (VDD), L9.3 (VDD), L10.3 (VDD), L11.3 (VDD), L12.3 (VDD), L13.3 (VDD), L14.3 (VDD), L15.3 (VDD), L16.3 (VDD), L17.3 (VDD), L18.3 (VDD), L19.3 (VDD), L20.3 (VDD), L21.3 (VDD), L22.3 (VDD), L23.3 (VDD), L24.3 (VDD), L25.3 (VDD), L26.3 (VDD), L27.3 (VDD), L28.3 (VDD), L29.3 (VDD), L30.3 (VDD), L31.3 (VDD), L32.3 (VDD), L33.3 (VDD), L34.3 (VDD), L35.3 (VDD), L36.3 (VDD), L37.3 (VDD), L38.3 (VDD), L39.3 (VDD), L40.3 (VDD), L41.3 (VDD), L42.3 (VDD), U1.21 (VCC)
col0: SW1.1, SW2.1, SW3.1, SW40.1, SW41.1, SW42.1, U1.19 (F5/PIN19)
col1: SW4.1, SW5.1, SW6.1, SW37.1, SW38.1, SW39.1, U1.18 (F6/PIN18)
col2: SW7.1, SW8.1, SW9.1, SW10.1, SW33.1, SW34.1, SW35.1, SW36.1, U1.17 (F7/PIN17)
col3: SW11.1, SW12.1, SW13.1, SW14.1, SW29.1, SW30.1, SW31.1, SW32.1, U1.6 (D0/PIN6/SCL)
col4: SW15.1, SW16.1, SW17.1, SW26.1, SW27.1, SW28.1, U1.7 (D4/PIN7)
col5: SW18.1, SW19.1, SW20.1, SW21.1, SW22.1, SW23.1, SW24.1, SW25.1, U1.8 (C6/PIN8)
reset: SW43.2, U1.22 (RST)
row0: D1.1 (K), D4.1 (K), D7.1 (K), D11.1 (K), D15.1 (K), D18.1 (K), U1.20 (F4/PIN20)
row1: D2.1 (K), D5.1 (K), D8.1 (K), D12.1 (K), D16.1 (K), D19.1 (K), U1.15 (B3/PIN15)
row2: D3.1 (K), D6.1 (K), D9.1 (K), D13.1 (K), D17.1 (K), D20.1 (K), U1.14 (B2/PIN14)
row3: D10.1 (K), D14.1 (K), D21.1 (K), U1.13 (B6/PIN13)
row4: D22.1 (K), D26.1 (K), D29.1 (K), D33.1 (K), D37.1 (K), D40.1 (K), U1.5 (D1/PIN5/SDA)
row5: D23.1 (K), D27.1 (K), D30.1 (K), D34.1 (K), D38.1 (K), D41.1 (K), U1.10 (E6/PIN10)
row6: D24.1 (K), D28.1 (K), D31.1 (K), D35.1 (K), D39.1 (K), D42.1 (K), U1.11 (B4/PIN11)
row7: D25.1 (K), D32.1 (K), D36.1 (K), U1.12 (B5/PIN12)

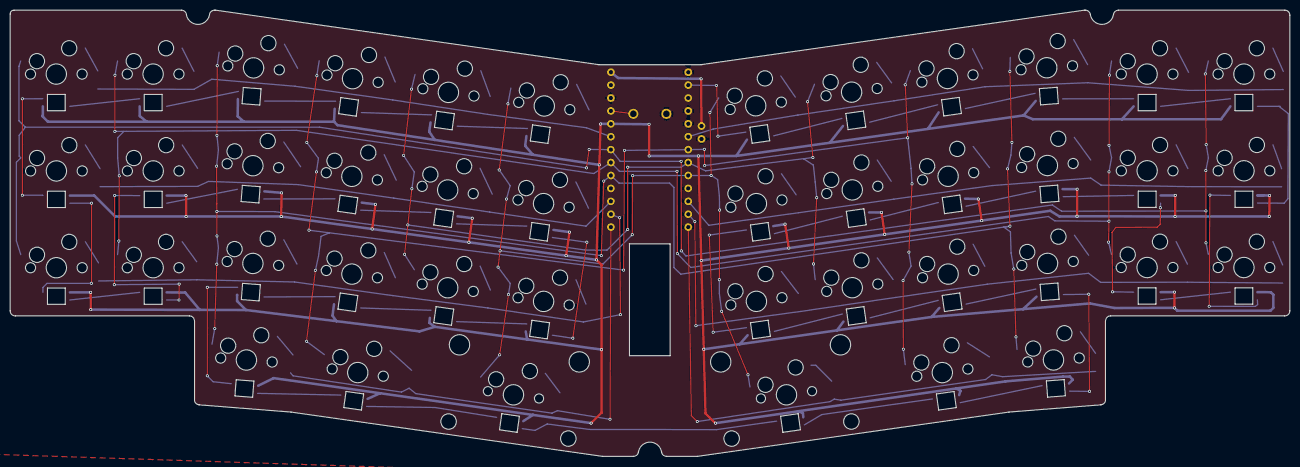
[picture p36: board cad/_restore_backup_2026-07-20T22-31-31-266/mami.kicad_pcb from above]

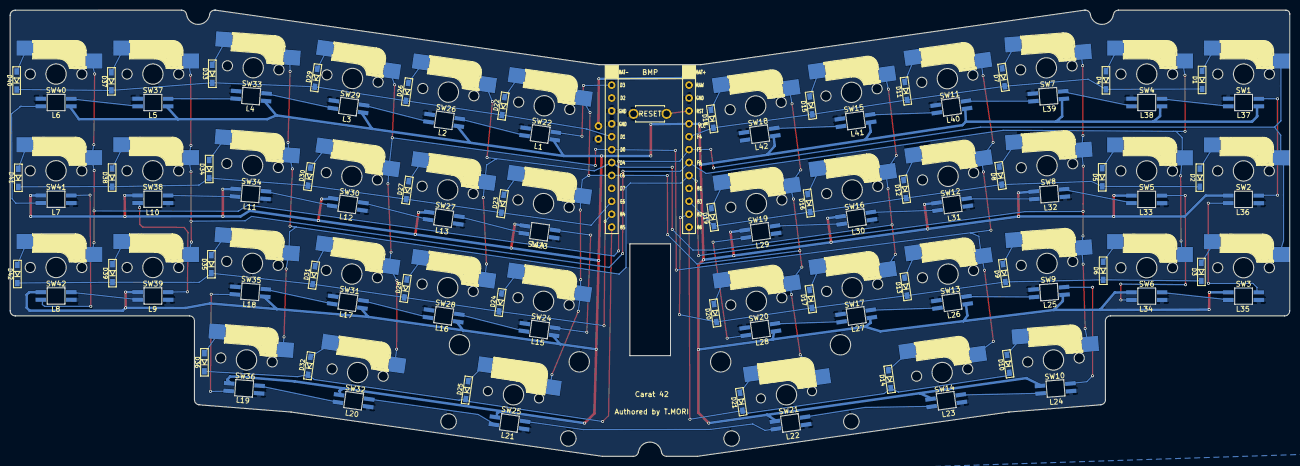
[picture p37: board cad/_restore_backup_2026-07-20T22-31-31-266/mami.kicad_pcb from below]

Board: 2 copper layers, 251.8 x 87.8 mm, 129 parts (2 on the bottom side), 102 nets.
