takunii/mami-kbd/cad/_restore_backup_2026-06-11T17-34-44-700/mami.kicad_pcb

## KiCad design cad/_restore_backup_2026-06-11T17-34-44-700/mami.kicad_pcb (2026-06-11, an earlier design)

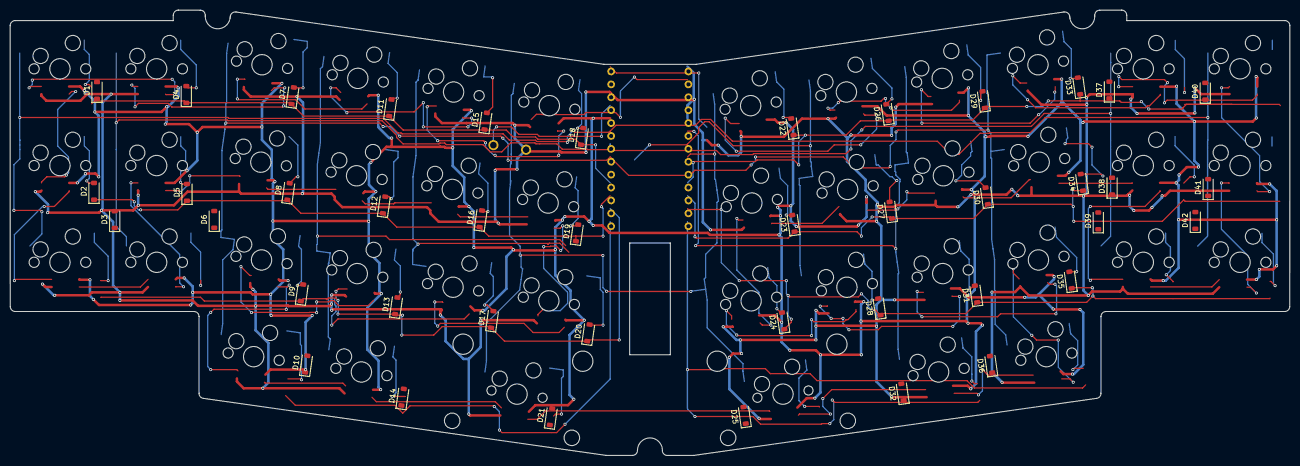
[picture p38: board cad/_restore_backup_2026-06-11T17-34-44-700/mami.kicad_pcb from above]

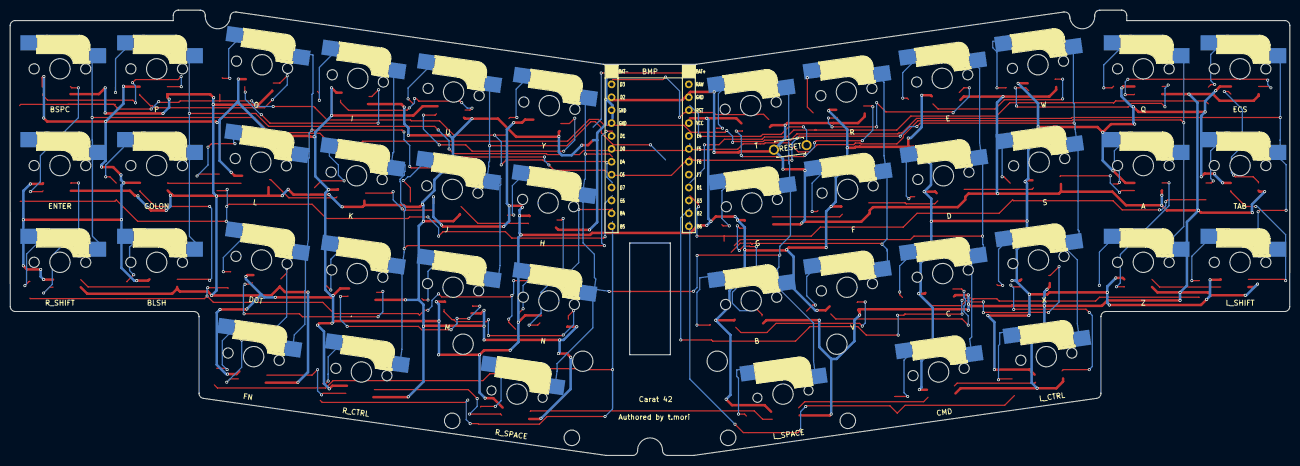
[picture p39: board cad/_restore_backup_2026-06-11T17-34-44-700/mami.kicad_pcb from below]

Board: 2 copper layers, 252.0 x 87.7 mm, 86 parts (2 on the bottom side), 58 nets.

Parts:
,: SW_Push; CherryMX_Hotswap_1u
A: SW_Push; CherryMX_Hotswap_1u
B: SW_Push; CherryMX_Hotswap_1u
BLSH: SW_Push; CherryMX_Hotswap_1u
BSPC: SW_Push; CherryMX_Hotswap_1u
C: SW_Push; CherryMX_Hotswap_1u
CMD: SW_Push; CherryMX_Hotswap_1.25u
COLON: SW_Push; CherryMX_Hotswap_1u
D: SW_Push; CherryMX_Hotswap_1u
D1, D2, D3, D4, D5, D6, D7, D8, D9, D10, D11, D12, D13, D14, D15, D16, D17, D18, D19, D20, D21, D22, D23, D24, D25, D26, D27, D28, D29, D30, D31, D32, D33, D34, D35, D36, D37, D38, D39, D40, D41, D42: 1N4148W; D_SOD-123
DOT: SW_Push; CherryMX_Hotswap_1u
E: SW_Push; CherryMX_Hotswap_1u
ECS: SW_Push; CherryMX_Hotswap_1u
ENTER: SW_Push; CherryMX_Hotswap_1u
F: SW_Push; CherryMX_Hotswap_1u
FN: SW_Push; CherryMX_Hotswap_1u
G: SW_Push; CherryMX_Hotswap_1u
H: SW_Push; CherryMX_Hotswap_1u
I: SW_Push; CherryMX_Hotswap_1u
J: SW_Push; CherryMX_Hotswap_1u
K: SW_Push; CherryMX_Hotswap_1u
L: SW_Push; CherryMX_Hotswap_1u
L_CTRL: SW_Push; CherryMX_Hotswap_1u
L_SHIFT: SW_Push; CherryMX_Hotswap_1u
L_SPACE: SW_Push; CherryMX_Hotswap_2u
M: SW_Push; CherryMX_Hotswap_1u
N: SW_Push; CherryMX_Hotswap_1u
O: SW_Push; CherryMX_Hotswap_1u
P: SW_Push; CherryMX_Hotswap_1u
Q: SW_Push; CherryMX_Hotswap_1u
R: SW_Push; CherryMX_Hotswap_1u
R_CTRL: SW_Push; CherryMX_Hotswap_1.25u
R_SHIFT: SW_Push; CherryMX_Hotswap_1u
R_SPACE: SW_Push; CherryMX_Hotswap_2u
S: SW_Push; CherryMX_Hotswap_1u
SW43: ResetSW
T: SW_Push; CherryMX_Hotswap_1u
TAB: SW_Push; CherryMX_Hotswap_1u
U: SW_Push; CherryMX_Hotswap_1u
U1: Micon_BLEMicroPro; Micon_BMP_7sKB
V: SW_Push; CherryMX_Hotswap_1u
W: SW_Push; CherryMX_Hotswap_1u
X: SW_Push; CherryMX_Hotswap_1u
Y: SW_Push; CherryMX_Hotswap_1u
Z: SW_Push; CherryMX_Hotswap_1u

Connections:
GND: SW43.1, U1.3 (GND), U1.4 (GND), U1.23 (GND), U1.26 (BAT-)
unnamed: D1.2 (A), ECS.2
unnamed: D2.2 (A), TAB.2
unnamed: D3.2 (A), L_SHIFT.2
unnamed: D4.2 (A), Q.2
unnamed: A.2, D5.2 (A)
unnamed: D6.2 (A), Z.2
unnamed: D7.2 (A), W.2
unnamed: D8.2 (A), S.2
unnamed: D9.2 (A), X.2
unnamed: D10.2 (A), L_CTRL.2
unnamed: D11.2 (A), E.2
unnamed: D.2, D12.2 (A)
unnamed: C.2, D13.2 (A)
unnamed: CMD.2, D14.2 (A)
unnamed: D15.2 (A), R.2
unnamed: D16.2 (A), F.2
unnamed: D17.2 (A), V.2
unnamed: D18.2 (A), T.2
unnamed: D19.2 (A), G.2
unnamed: B.2, D20.2 (A)
unnamed: D21.2 (A), L_SPACE.2
unnamed: D22.2 (A), Y.2
unnamed: D23.2 (A), H.2
unnamed: D24.2 (A), N.2
unnamed: D25.2 (A), R_SPACE.2
unnamed: D26.2 (A), U.2
unnamed: D27.2 (A), J.2
unnamed: D28.2 (A), M.2
unnamed: D29.2 (A), I.2
unnamed: D30.2 (A), K.2
unnamed: ,.2, D31.2 (A)
unnamed: D32.2 (A), R_CTRL.2
unnamed: D33.2 (A), O.2
unnamed: D34.2 (A), L.2
unnamed: D35.2 (A), DOT.2
unnamed: D36.2 (A), FN.2
unnamed: D37.2 (A), P.2
unnamed: COLON.2, D38.2 (A)
unnamed: BLSH.2, D39.2 (A)
unnamed: BSPC.2, D40.2 (A)
unnamed: D41.2 (A), ENTER.2
unnamed: D42.2 (A), R_SHIFT.2
col0: BSPC.1, ECS.1, ENTER.1, L_SHIFT.1, R_SHIFT.1, TAB.1, U1.20 (F4/PIN20)
col1: A.1, BLSH.1, COLON.1, P.1, Q.1, U1.19 (F5/PIN19), Z.1
col2: DOT.1, FN.1, L.1, L_CTRL.1, O.1, S.1, U1.18 (F6/PIN18), W.1, X.1
col3: ,.1, C.1, CMD.1, D.1, E.1, I.1, K.1, R_CTRL.1, U1.5 (D1/PIN5/SDA)
col4: F.1, J.1, M.1, R.1, U.1, U1.6 (D0/PIN6/SCL), V.1
col5: B.1, G.1, H.1, L_SPACE.1, N.1, R_SPACE.1, T.1, U1.7 (D4/PIN7), Y.1
reset: SW43.2, U1.22 (RST)
row0: D1.1 (K), D4.1 (K), D7.1 (K), D11.1 (K), D15.1 (K), D18.1 (K), U1.16 (B1/PIN16)
row1: D2.1 (K), D5.1 (K), D8.1 (K), D12.1 (K), D16.1 (K), D19.1 (K), U1.15 (B3/PIN15)
row2: D3.1 (K), D6.1 (K), D9.1 (K), D13.1 (K), D17.1 (K), D20.1 (K), U1.14 (B2/PIN14)
row3: D10.1 (K), D14.1 (K), D21.1 (K), U1.13 (B6/PIN13)
row4: D22.1 (K), D26.1 (K), D29.1 (K), D33.1 (K), D37.1 (K), D40.1 (K), U1.9 (D7/PIN9)
row5: D23.1 (K), D27.1 (K), D30.1 (K), D34.1 (K), D38.1 (K), D41.1 (K), U1.10 (E6/PIN10)
row6: D24.1 (K), D28.1 (K), D31.1 (K), D35.1 (K), D39.1 (K), D42.1 (K), U1.11 (B4/PIN11)
row7: D25.1 (K), D32.1 (K), D36.1 (K), U1.12 (B5/PIN12)
