takunii/mami-kbd/(commit log)

2026-04-15 cadでswitchを配置
    [.kicad_sch, .kicad_sch.kicad_sch, cad.kicad_pcb, mami-reverse.kicad_sch, mami.kicad_pcb, mami.kicad_sch]
2026-04-15 キーキャップ変更 shift->1.25u caps->1u
    [mami.kicad_pcb]
2026-04-16 pcb update
    [mami.kicad_pcb]
2026-04-16 symmetric schema update pcb
    [mami.kicad_pcb, mami.kicad_sch]
2026-04-18 drawing edge
    [mami.kicad_pcb]
2026-04-18 make corner round
    [mami.kicad_pcb]
2026-04-19 silicon gasket hole
    [mami.dsn, mami.kicad_pcb]
2026-04-29 回路図エディターをbattery有り＋LED有りに変更
    [mami.kicad_pcb, mami.kicad_sch]
2026-04-29 LEDのフットプリント更新
    [mami.kicad_sch]
2026-04-30 LED向き変更
    [mami.kicad_pcb, mami.kicad_sch]
2026-05-01 ON/OFFスイッチを削除
    [alice.sch, cad.kicad_pcb, cad.kicad_sch, mami-reverse.kicad_sch, mami.dsn, mami.kicad_pcb, mami.kicad_sch, matrix.sch]
2026-05-01 reverse diode direction
    [mami.dsn, mami.kicad_pcb, mami.kicad_sch]
2026-05-01 pcb枠を修正
    [mami.kicad_pcb]
2026-05-01 自動配線
    [mami.dsn, mami.kicad_pcb]
2026-05-01 routing width > 0.250mm
    [mami.kicad_pcb]
2026-05-03 make stabilizer hole upside down
    [mami.dsn]
2026-05-04 ラベリング
    [mami.kicad_pcb]
2026-05-04 自動配線エラーを修正
    [mami.kicad_pcb]
2026-05-04 署名を追加
    [mami.kicad_pcb]
2026-05-04 output step file
    [mami.step]
2026-06-06 ケースデータ修正
    [.step, carot48.step, mami-Edge_Cuts.dxf, mami-User_Drawings.dxf, mami.dxf, mami.kicad_pcb, ケースデータ.xlsx]
2026-06-10 配置変更途中
    [carot48.step, case_bottom.step, case_top.step, mami.kicad_pcb]
2026-06-11 libraryを追加
2026-06-11 frame chaning
    [mami.kicad_pcb, mami.kicad_sch, routing_260611.dsn]
2026-06-15 手動配線
    [.kicad_sch.kicad_sch, CUI_DEVICES_SJ-43504-SMT-TR.step, CUI_SJ-43614-SMT-TR.step, EC11B-SW-Horiz-15K-blue.step, HRO TYPE-C-31-M-12.step, PJ-320A.step, SK6812MINI-E v1.step, W25Q16JVUXIQ.step]
2026-06-16 未接続0
    [mami.kicad_pcb]
2026-06-16 error 0 git add *
    [mami.kicad_pcb]
2026-08-04 Add ZMK firmware build config for mami42 (nice_nano_v2)
    GitHub Actionsでビルドできるよう、build.yaml・west.yml・shield定義
    (boards/shields/mami42)・keymap一式を追加。keymapのbindings配列は
    見た目通りの行優先で書かれていたため、mami42.overlayのdefault_transform
    (SW1〜SW42の物理位置順、親指キーが列グループに割り込む列優先)に
    合わせて全6レイヤーを並べ替えて修正。
    [mami42.overlay]
2026-08-04 Fix SW32 thumb key width to match kle/layout.json
    右親指クラスタのSW32を左親指のSW14(1.25u)と対称になるよう
    1u→1.25uに修正。kle/layout.jsonのw:1.25指定がKLE形式では後続の
    SW36にも継続適用されてしまうため、SW36側は明示的にw:1へリセット。
    [mami42.overlay]
2026-08-05 Fix nice_nano board id for Zephyr 4.1 HWMv2 migration
    GitHub ActionsのビルドがCMake Error "No board named 'nice_nano_v2' found"
    で失敗していた。ZMK main branchがZephyr 4.1のHWMv2に移行し、
    nice_nano_v2は独立したボード名ではなくnice_nanoボードの
    revision(2.0.0, デフォルト)に統合されたため、build.yamlのboard指定を
    nice_nano//zmkに変更。あわせてmami42.zmk.ymlのrequiresも
    nice_nano_v2からnice_nano側が実際にexposeしているpro_microに修正。
2026-08-05 Add zephyr/module.yml so boards/shields/ is discovered
    GitHub Actionsのビルドが "No shield named 'mami42' found" で失敗していた。
    west/ZephyrはKconfig.shieldがあるだけではboards/shields/配下を
    自動探索しない。self.path=configのzmk-configリポジトリでリポジトリ
    直下のboards/を認識させるには、公式のunified-zmk-config-templateと
    同様にリポジトリ直下にzephyr/module.yml (board_root: .) を置く必要が
    あるため追加。.gitignoreも/zephyr/配下のうちmodule.ymlだけ除外解除。
2026-08-05 Fix missing commas in physical layout keys property
    devicetreeでは複数の<...>グループ(phandle+args)はカンマ区切りが
    必要だが、default_layoutのkeysプロパティは42エントリすべてカンマ
    なしで並んでいたため、GitHub Actionsのビルドで
    "devicetree error: ... parse error: expected ';' or ','" が発生。
    ZMK公式のphysical-layout実例(reviung41.dtsi等)に倣い、各エントリの
    前にカンマを追加。
    [mami42.overlay]
2026-08-05 Parenthesize negative rotation values in physical layout
    devicetreeでは負数を裸で書けず、括弧で囲む必要がある
    (ZMK公式実例と同様の (-700) 形式)。右手側の-800(°)回転値が
    未対応だったため "parse error: expected number or parenthesized
    expression" が発生していた。SW22-36の(-800)に修正。
    [mami42.overlay]
2026-08-05 Fix deprecated shield_is Kconfig macro
    ZMK main branchのKconfigマクロがshield_isからshields_list_contains
    に変更されており(Zephyr 4.1 HWMv2移行に伴う変更)、旧マクロ名のままだと
    "macro expanded to blank string" でビルド失敗していた。公式の
    new-shield.mdxの現行サンプルに合わせて修正。
2026-08-05 Add studio-rpc-usb-uart snippet for ZMK Studio over USB
    CONFIG_ZMK_STUDIO=yだけではUSB経由のStudio通信用エンドポイントが
    ビルドされず、PCがUSBシリアルとして認識できなかった。build.yamlに
    snippet: studio-rpc-usb-uart を追加。
2026-08-05 Bind &studio_unlock to enable ZMK Studio editing
    ZMK StudioでUSB接続はできるようになったが、変更の保存には
    &studio_unlock のロック解除操作が必須。symレイヤー(mac_sym/win_sym)の
    SW2(ESC位置、空きキー)に割り当てた。右親指のMO(2/5)を押しながら
    SW2でロック解除できる。
2026-08-07 Move &studio_unlock to SW1 for simpler unlock
    SW2ではなくSW1(sym レイヤー)に変更し、右親指のMO(2/5)を押しながら
    一番左上のキー(SW1)だけでロック解除できるようにした。
    SW1にあったEXCL(!)は削除。
2026-08-07 Move &studio_unlock to base layer SW1 (single-key unlock)
    レイヤー修飾なしでSW1単押しだけでZMK Studioのロック解除ができるよう、
    mac_base/win_baseのSW1(元TAB)に&studio_unlockを割り当て。
    symレイヤーのSW1はEXCLに戻した。
2026-08-07 Bind &studio_unlock to all mac_base keys for initial bring-up
    配線確認・初期セットアップのため、mac_baseレイヤーの全42キーを
    一時的に&studio_unlockにした。どのスイッチを押してもロック解除
    できるので、マトリクス動作確認も兼ねられる。元のバインディングは
    各行のコメントに残してあるので、後で通常のキーマップに戻せる。
2026-08-08 Fix row/col GPIO assignments to match actual PCB wiring
    cad/mami.kicad_pcb のネット情報(パッド番号→row/col信号名)と、
    nice!nano公式ピン配置(GND/VCC/RST位置で照合済み)を突き合わせた結果、
    row0〜row4・col0〜col2のGPIO割り当てがoverlayの記載と実際のPCB配線で
    食い違っていることが判明(row5〜7・col3〜5は元から正しかった)。
    ユーザーが実測したピン対応表と一致することを確認し、
    mami42.overlayのrow-gpios/col-gpiosを実配線に合わせて修正。
    doc/pin-assignment-final.mdの内容が古い(計画段階のまま)だったため
    訂正メモを追加。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
    [mami42.overlay]
2026-08-08 Add RGB underglow support for per-key SK6812MINI-E LEDs
    PCB(cad/mami.kicad_pcb)を確認したところ、SK6812MINI-E(WS2812互換)が
    L1〜L42まで42個、各キーに1個ずつ搭載されており、データラインは
    nice!nanoのP0.06からL1→L2→...→L42へ一直線にデイジーチェーン接続
    されていた(doc/CLAUDE.mdでは「LEDなし」となっていたが、実際の基板には
    搭載されている)。
    - boards/shields/mami42/boards/nice_nano_nrf52840_zmk.overlay を追加
    (ZMK公式ドキュメントのP0.06サンプルと同一構成。spi3+ws2812、
    chain-length=42)
    - config/mami42.conf に CONFIG_ZMK_RGB_UNDERGLOW=y を追加
    - キーマップにdt-bind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
2026-08-08 Restore normal typing keymap for mac_base
    初期動作確認用に全キーを&studio_unlockにしていたmac_baseを、
    通常のQWERTYタイピングキーマップに戻した。SW1は&studio_unlockの
    ままにしてある(単押しでロック解除できる仕様を維持)。
2026-08-09 Remove studio lock, add BT profile select and RGB hue/brightness
    - config/mami42.conf: CONFIG_ZMK_STUDIO_LOCKING=n でロック不要に変更
    - keymap: SW1を&studio_unlockから&kp TABに戻す
    - mac_num/win_numのSW2/SW3/SW5に&bt BT_SEL 0/1/2 (BLEプロファイル1/2/3切替)
    - mac_sym/win_symにRGB_HUI/RGB_HUD(色相)、RGB_BRI/RGB_BRD(輝度)を追加
    (既存のRGB_TOG/RGB_EFFと合わせて色相・輝度・モードを操作可能に)
    - mami42.overlayのRC(6,4tu)というタイプミスを RC(6,4) に修正
2026-08-09 Redesign mac_base/mac_num per new layout spec
    mac_base: GRAVE(SW1), mod-tap LCTRL/TAB(SW2), LALT(SW10),
    layer-tap 1/BSPC(SW21), layer-tap 1/SPACE(SW25), 追加のmo(2)をSW36にも
    割り当て、SW37をMINUSに変更。
    mac_num: ESC(SW1)、矢印キー(SW5/8/12/16)、Home/PgUp/PgDn/End
    (SW6/9/13/17)、数字段をSW4,7,11,15,18,22,26,29,33,40に再配置、
    括弧・記号類を追加。SW21/SW25のbkspc/spaceも明示的に設定。
    BT_SEL 0/1/2はSW5と衝突したためSW2/SW3/SW19に移動。
2026-08-09 Fix P/MINUS placement, add mac_system layer, relocate RGB controls
    - mac_base: SW37をPに戻し、SW40をMINUSに変更(ユーザー訂正反映)
    - mac_sym(layer2)をmac_systemに置き換え: F1〜F10(SW4,7,11,15,18,22,
    26,29,33,37)+F12(SW40)、画面輝度(SW6/9)、音量(SW13/17)、
    ミュート(SW20)
    - RGB操作(TOG/EFF/HUI/HUD/BRI/BRD)をmac_numの空きキー
    (SW20,23,24,28,31,35)に移動(mac_sym廃止に伴う退避先)
2026-08-09 Regenerate win_base/win_num/win_system from mac_* layers
    mac_base のSW10とSW14を入れ替えてwin_baseを作成(&mo 1/&lt 1は
    win_num(4)/win_system(5)参照に付け替え)。mac_num/mac_systemは
    SW10・SW14が両方&transのため入れ替えの影響がなく、win_num/
    win_system(旧win_sym)としてそのままコピー。ヘッダコメントと
    OS切り替えコンボの説明も実態に合わせて更新。
2026-08-09 Fix SW36 x-position overlapping SW32 in ZMK Studio layout
    SW32を1.25uに広げた際(SW32幅修正コミット)、右隣のSW36のx座標を
    ズラしていなかったため25unit分重なっていた。SW32の右端(926+125=1051)
    にSW36の左端を合わせるよう x を 1026→1051 に修正。左親指側の
    SW10/SW14/SW21(隙間なく隣接)と同じパターンに揃えた。
    [mami42.overlay]
2026-08-09 Update mac_base/mac_num/mac_system per new requests (mirrored to win_*)
    mac_base: SW32→RALT(旧mo2), SW14→LGUI(旧mo1), SW41→RET(旧SQT)。
    win_baseも同じ内容にミラー(SW10/SW14入れ替えルール適用)。
    mac_num: SW37とSW40を入れ替え、SW40が"="になるようにした
    (SW37は0に)。win_numも同様。
    mac_system: Fキー配列をSW1始まりに変更しF11を追加
    (SW1=F1〜SW37=F11、SW40=F12)。win_systemも同様。
2026-08-15 Add named BLT1/BLT2/BLT3/USB macros for ZMK Studio
    &bt BT_SEL n / &out OUT_USB をラップしたマクロ(blt1/blt2/blt3/usb_out)
    を追加し、display-nameでZMK Studioのビヘイビア一覧に「BLT1」
    「BLT2」「BLT3」「USB」として単独項目で表示されるようにした
    (&bt/&outの汎用表示名+パラメータ選択ではなく、ワンクリックで選べる
    ショートカットとして扱える)。mac_num/win_numの既存BT_SEL 0/1/2は
    blt1/blt2/blt3に置き換え。usb_outは今のところ未配置(Studioから
    好きなキーに割り当て可能)。
